XaverBandi/Qlockthree_Eva_und_Xaver/Photos/15.jpg

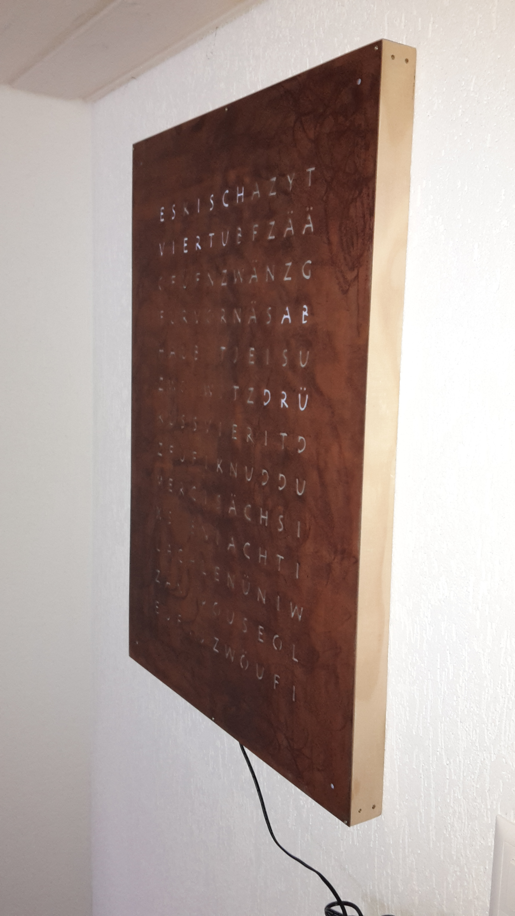
Photos/15.jpg
