XaverBandi/Qlockthree_Eva_und_Xaver/Photos/04.jpg

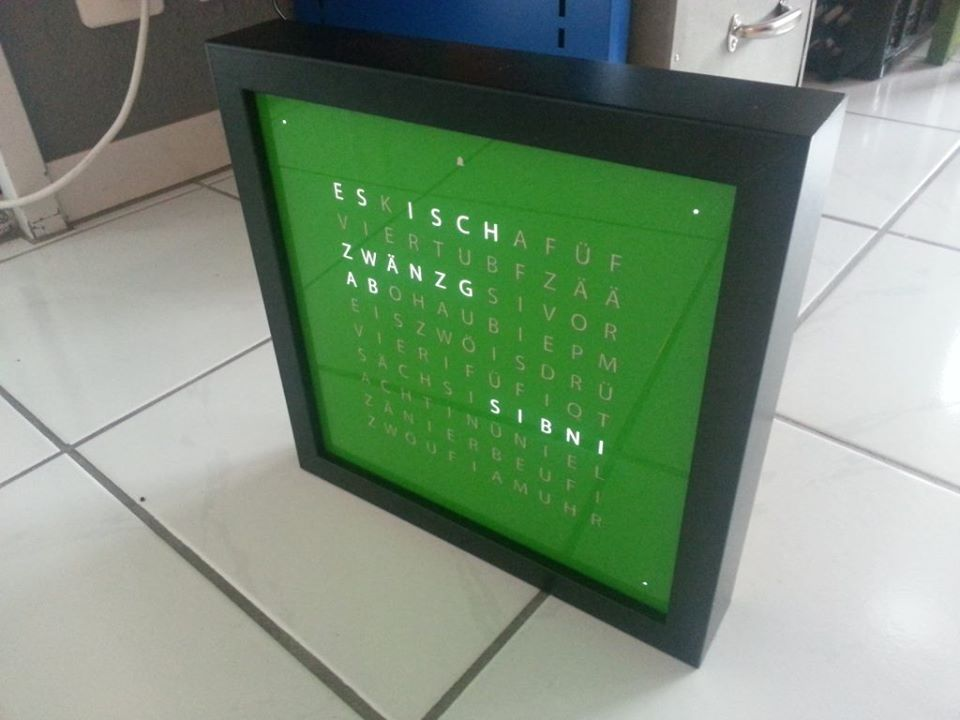
Photos/04.jpg
