XaverBandi/Qlockthree_Eva_und_Xaver/Anleitung/More/QLOCKTWO_Poster.pdf

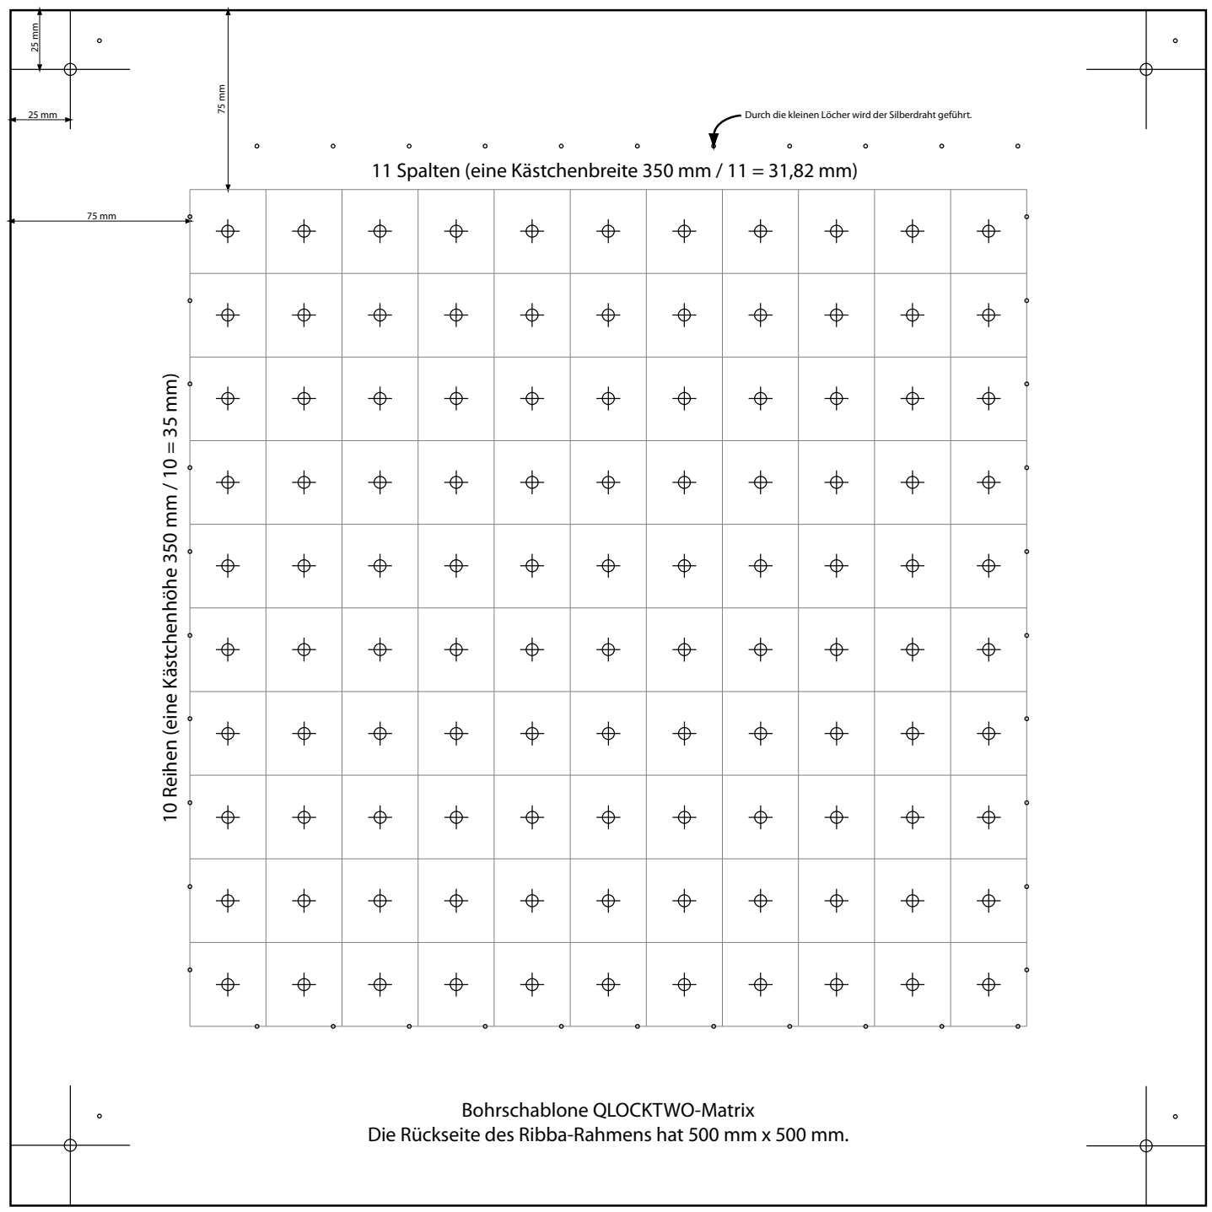
[picture p3: figure]
Bohrschablone QLOCKTWO-Matrix
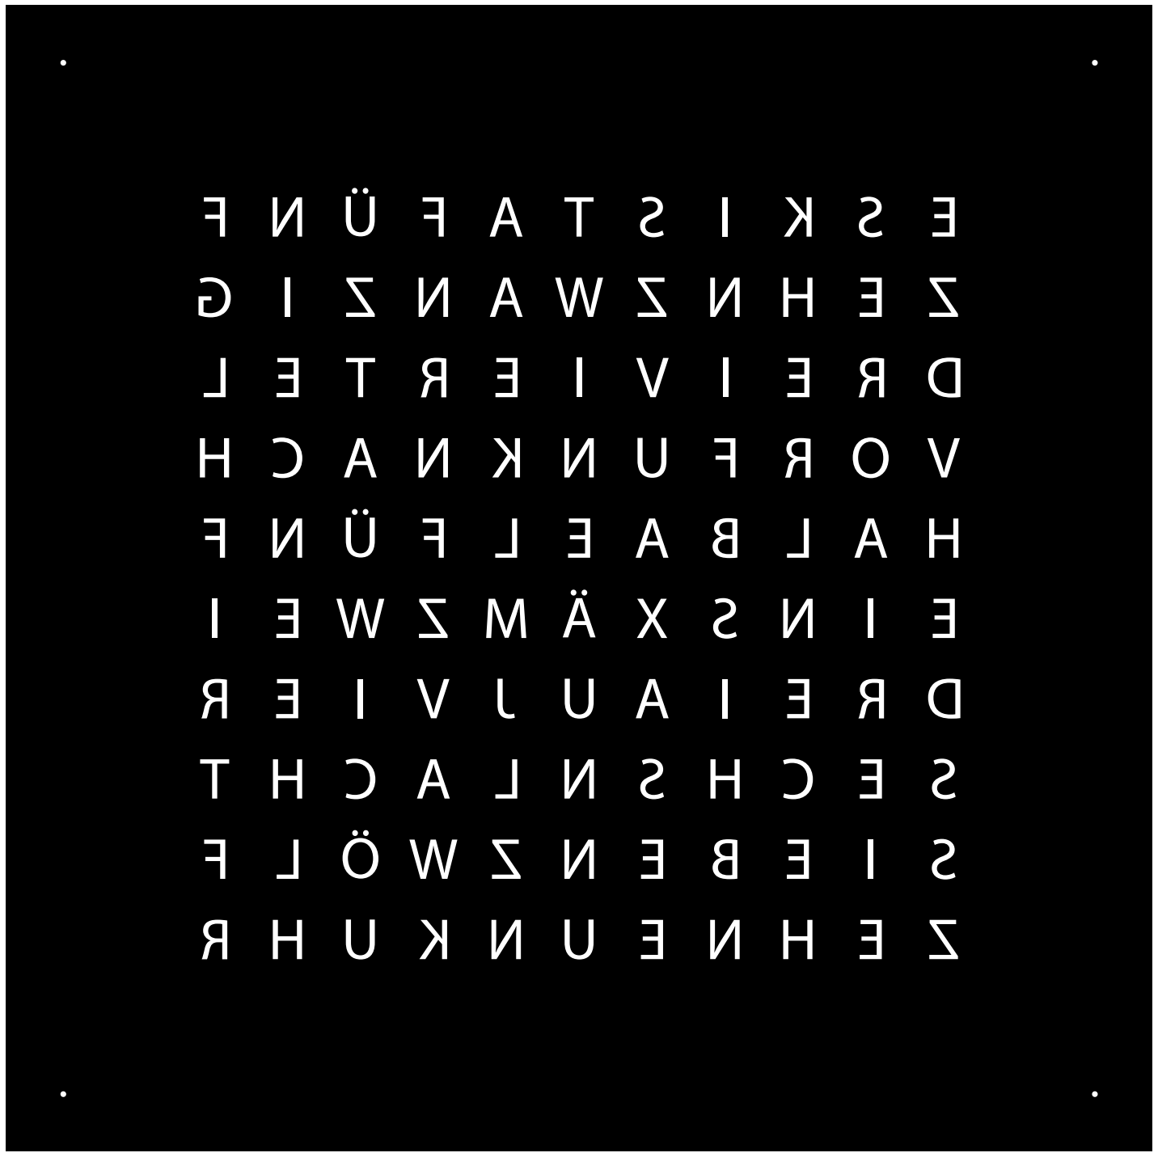
[picture p4: figure]

## 11 Spalten (eine Kästchenbreite 350 mm / 11 = 31,82 mm)

## 10 Reihen (eine Kästchenhöhe 350 mm / 10 = 35 mm)

Die Rückseite des Ribba-Rahmens hat 500 mm x 500 mm.

Durch die kleinen Löcher wird der Silberdraht geführt.

ache Seite,
kurzes Bein
= Kathode

runde Seite,
langes Bein
= Anode

## Lötschema QLOCKTWO-Matrix

Durch die kleinen Löcher wird der Silberdraht geführt.

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
STCLK

SHCLK
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
STCLK

SHCLK
MR

Q7‘

### Serial-In

### (vom Anoden-Multiplexer)

### Output-Enable

### Store-Clock (Latch)

### Serial-Clock

### Q0-Q7 und Q0-Q2 Matrix (GND)

### Q3-Q6 je eine Kathode

der Eck-LEDs. Oben links,
oben rechts, unten rechts, unten links.

Silberdraht Vcc
(Lötseite!)

Silberdraht GND
(Lötseite!)
1. Spalte
der LED-Matrix!

# Der Kathoden-Multiplexer:

# Der Anoden-Multiplexer:

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
STCLK

SHCLK
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
STCLK

SHCLK
MR

Q7‘

### Serial-In

### (vom RBBB)

### Output-Enable

### Store-Clock (Latch)

### Serial-Clock Serial-Out

### (zum Kathoden-Multiplexer)

Silberdraht Vcc
(Lötseite!)

Silberdraht GND
(Lötseite!)

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
OUT1

OUT2

OUT3

OUT4

OUT5

OUT6

OUT7

OUT8
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
OUT1

OUT2

OUT3

OUT4

OUT5

OUT6

OUT7

OUT8
GND

Out1-Out8 und Out1-Out2
zu den Anoden der Matrix | 1. Reihe
| der LED-
| Matrix!

# Die Steuerplatine:

### Signal vom DCF77-Empfänger

# Serial-Out (zum Anoden-Multiplexer) Taster „Modus“ Taster „Stunde+“

### Taster „Minute+“

### (alle zurück zu VCC)

### Output-Enable

### Store-Clock (Latch)

### Serial-Clock

Silberdraht Vcc
(Lötseite!)

Silberdraht GND
(Lötseite!)

3V für DCF77-Empfänger

X1

X2

VBAT

GND

VCC

SQW
SCL

SDA

### Achtung!

Quarz ist auf der Lötseite,

### damit das Gehäuse an GND liegen kann!

### Optionaler Schaltungsteil, für eine licht-

abhängige Steuerung.

D10

D11

D12

D13

GND

AREF
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
# ATMega 328 Rahmen

# Glasplatte

# Folie

# Diffusorfolie

# Abstandshalter

# Lichtleitgitter

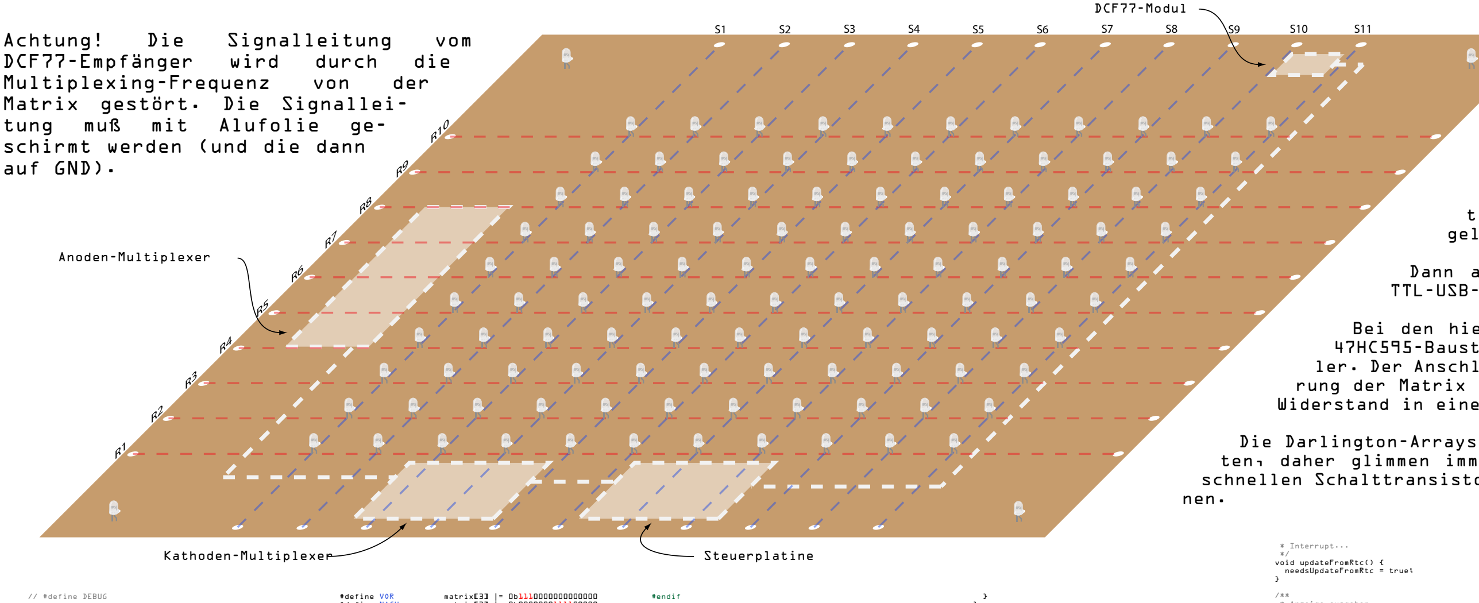
[picture p5: figure]
Anoden-Multiplexer; Kathoden-Multiplexer; Steuerplatine; DCF77-Modul; // #define DEBUG; #define VOR; matrix[3] |= 0b1110000000000000; #endif; * Interrupt... */ void updateFromRtc() { needsUpdateFromRtc = true;; nen.; Achtung!; Die; Signalleitung; vom; DCF77-Empfänger; wird; durch; die; Multiplexing-Frequenz; von; der; Matrix gestört. Die Signallei-; tung; muß; mit; Alufolie; schirmt werden (und die dann auf GND).

/**
* QLOCKTWO-Software
* V3, by Christian
* 2010/2011
*/

#include <Wire.h> // Wire library fuer I2C

#include "Dcf77.h"

#define DS1307_I2C_ADDRESS 0x68 // Die Real-Time-Clock

/**
* Definition der Zahlen.
*/
const byte zahl[10][7] = { {
0b00001110,
0b00010001,
0b00010011,
0b00010101,
0b00011001,
0b00010001,
0b00001110
}, {
0b00000010,
0b00000110,
0b00000010,
0b00000010,
0b00000010,
0b00000010,
0b00000111
}, {
0b00001110,
0b00010001,
0b00000001,
0b00000010,
0b00000100,
0b00001000,
0b00011111
}, {
0b00011111,
0b00000010,
0b00000100,
0b00000010,
0b00000001,
0b00010001,
0b00001110
}, {
0b00000010,
0b00000110,
0b00001010,
0b00010010,
0b00011111,
0b00000010,
0b00000010
}, {
0b00011111,
0b00010000,
0b00011110,
0b00000001,
0b00000001,
0b00010001,
0b00001110
}, {
0b00000110,
0b00001000,
0b00010000,
0b00011110,
0b00010001,
0b00010001,
0b00001110
}, {
0b00011111,
0b00000001,
0b00000010,
0b00000100,
0b00001000,
0b00001000,
0b00001000
}, {
0b00001110,
0b00010001,
0b00010001,
0b00001110,
0b00010001,
0b00010001,
0b00001110
}, {
0b00001110,
0b00010001,
0b00010001,
0b00001111,
0b00000001,
0b00000010,
0b00001100
}
};

/**
* Definition der Woerter.
*/
#define NACH | matrix[3] |= 0b0000000111100000

#define ESIST | matrix[0] |= 0b1101110000000000

#define UHR | matrix[9] |= 0b0000000011100000

#define FUENF | matrix[0] |= 0b0000000111100000

#define ZEHN | matrix[1] |= 0b1111000000000000

#define VIERTEL | matrix[2] |= 0b0000111111110000

#define ZWANZIG | matrix[1] |= 0b0000111111100000

#define HALB | matrix[4] |= 0b1111000000000000

#define DREIVIERTEL | matrix[2] |= 0b1111111111100000

#define H_EIN | matrix[5] |= 0b1110000000000000

#define H_EINS | matrix[5] |= 0b1111000000000000

#define H_ZWEI | matrix[5] |= 0b0000000111100000

#define H_DREI | matrix[6] |= 0b1111000000000000

#define H_VIER | matrix[6] |= 0b0000000111100000

#define H_FUENF | matrix[4] |= 0b0000000111100000

#define H_SECHS | matrix[7] |= 0b1111100000000000

#define H_SIEBEN | matrix[8] |= 0b1111110000000000

#define H_ACHT | matrix[7] |= 0b0000000111100000

#define H_NEUN | matrix[9] |= 0b0001111000000000

#define H_ZEHN | matrix[9] |= 0b1111000000000000

#define H_ELF | matrix[4] |= 0b0000011100000000

#define H_ZWOELF | matrix[8] |= 0b0000001111100000

/**
* Der serielle Ausgang zu den Multiplexern.
*/
#define latchPin | 11

#define clockPin | 12

#define dataPin | 10

#define outputEnablePin | 3

/**
* Die Funkuhr.
*/
#define dcf77Led | 8

#define dcf77Signal | 9

Dcf77 dcf77(dcf77Signal);
/**
* Das Rechtecksignal der RTC fuer den Interrupt. */
#define rtcSQWLed | 4

#define rtcSQWSignal | 2

/**
* Die Tasten.
*/
#define minutePlusPin 5

#define hourePlusPin | 6

#define modePin | 7

/**
* Die Modi.
*/
#define NORMAL | 0

#define SECONDS | 1

#define SCRAMBLE | 2

#define BLANK | 3

#define ALL | 4

#define MAX | 5

int mode = NORMAL;
/**
* Für das Entprellen der Tasten.
*/
unsigned long lastMinutePlusPress = 0; unsigned long lastHourePlusPress = 0; unsigned long lastModePress = 0;

// Ueber die Wire-Library festgelegt:
// Arduino analog input 4 = I2C SDA
// Arduino analog input 5 = I2C SCL

// Die Matrix, eine Art Bildschirmspeicher... word matrix[16];

// Die letzten Zeitstempel und Minutenabstände #define MAX_STEMPEL 4
long zeitstempelDcf77[MAX_STEMPEL];
long zeitstempelRtc[MAX_STEMPEL];

// Die Zeit...
byte second = 1;
byte minute = 1;
byte hour = 1;
byte dayOfWeek = 1;
byte dayOfMonth = 1;
byte month = 1;
byte year = 1;

// Hilfsvariable, da I2C und Interrupts // nicht zusammenspielen...
volatile boolean needsUpdateFromRtc = true;

/**
* Doku...
* 1. Fehler -> Falsche LED
* 2. Fehler -> Seltsames Verhalten mit Mac+USB+3.3v * 3. Fehler -> attachInterrupt & die Wire-Library
* | gehen nicht zusammen!
*/
void setup() {
#ifdef DEBUG

Serial.begin(57600);
Serial.println("Starting in debug-mode...");

Wire.begin(); // starte Wire library als I2C-Bus Master

pinMode(latchPin, OUTPUT);
pinMode(clockPin, OUTPUT);
pinMode(dataPin, OUTPUT);
pinMode(outputEnablePin, OUTPUT); digitalWrite(outputEnablePin, LOW);

pinMode(minutePlusPin, INPUT); pinMode(hourePlusPin, INPUT); pinMode(modePin, INPUT);
lastMinutePlusPress = millis(); lastHourePlusPress = millis(); lastModePress = millis();

pinMode(dcf77Signal, INPUT); digitalWrite(dcf77Signal, HIGH); pinMode(dcf77Led, OUTPUT); digitalWrite(dcf77Led, HIGH);

pinMode(rtcSQWSignal, INPUT); digitalWrite(rtcSQWSignal, HIGH); pinMode(rtcSQWLed, OUTPUT); digitalWrite(rtcSQWLed, HIGH);

clear();

getDateDs1307();

attachInterrupt(0, updateFromRtc, CHANGE);

for(int i=0; i<MAX_STEMPEL; i++) { zeitstempelDcf77[i] = i;
zeitstempelRtc[i] = i+1;
}
}

void loop() {
// via Interrupt gesetzt ueber Flanke des // SQW-Signals von der RTC
if (needsUpdateFromRtc) {
clear();
getDateDs1307();

switch (mode) {
case NORMAL:
setWords(hour, minute);
setMinutes(minute);
break;
case SECONDS:
for (int i = 0; i < 7; i++) {
matrix[1 + i] |= zahl[second / 10][i] << 11; }
for (int i = 0; i < 7; i++) {
matrix[1 + i] |= zahl[second % 10][i] << 5; }
break;
case SCRAMBLE:
scramble();
break;
case BLANK:
clear();
break;
case ALL:
all();
break;
}

needsUpdateFromRtc = false; }

// Taste Minuten++?
if (digitalRead(minutePlusPin) == HIGH) {
if (lastMinutePlusPress + 200 < millis()) { #ifdef DEBUG
Serial.println("\nMinutes plus pressed..."); #endif
minute++;
if (minute > 59) {
minute = 1;
}
setDateDs1307();
lastMinutePlusPress = millis(); needsUpdateFromRtc = true;
}
}

// Taste Stunden++?
if (digitalRead(hourePlusPin) == HIGH) {
if (lastHourePlusPress + 200 < millis()) { #ifdef DEBUG
Serial.println("\nHours plus pressed..."); #endif
hour++;
if (hour > 12) {
hour = 1;
}
setDateDs1307();
lastHourePlusPress = millis(); needsUpdateFromRtc = true;

}

// Taste Moduswechsel?
if (digitalRead(modePin) == HIGH) { if (lastModePress + 200 < millis()) {
mode++;
#ifdef DEBUG

Serial.print("\nChange mode pressed, mode is now "); Serial.print(mode);
Serial.println("...");
#endif

if(mode == MAX) {
mode = 0;
}
lastModePress = millis();
needsUpdateFromRtc = true;
}
}

// Die Matrix auf die LEDs multiplexen... if(mode != BLANK) {
writeMatrix();
}

// Status-LEDs ausgeben...
digitalWrite(dcf77Led, digitalRead(dcf77Signal)); digitalWrite(rtcSQWLed, digitalRead(rtcSQWSignal));

const char *v = dcf77.getDateTime();
if (strcmp (v, "DCF77POLL") != 0) {
#ifdef DEBUG

Serial.print("Captured:_"); Serial.println(v);
#endif

if(dcf77.getYear() > 2010) {
long dcf77inMinutes = dcf77.getHoures()*60 + dcf77.getMinutes();
long rtcInMinutes = hour*60 + minute; #ifdef DEBUG
Serial.print("\ndcf77inMinutes: "); Serial.println(dcf77inMinutes); Serial.print("rtcInMinutes: "); Serial.println(rtcInMinutes);
#endif

for(int i=0; i<MAX_STEMPEL-1; i++) { zeitstempelDcf77[i] = zeitstempelDcf77[i+1]; zeitstempelRtc[i] = zeitstempelRtc[i+1];
}
zeitstempelDcf77[MAX_STEMPEL-1] = dcf77inMinutes; zeitstempelRtc[MAX_STEMPEL-1] = rtcInMinutes;

// stimmen die Abstände im Array?
boolean ok = true;
for(int i=0; i<MAX_STEMPEL-1; i++) { if((zeitstempelDcf77[i] - zeitstempelDcf77[i+1]) != (zeitstempelRtc[i] - zeitstempelRtc[i+1])) { ok = false;
#ifdef DEBUG

Serial.print("Diff #");
Serial.print(i);
Serial.print(" is false ("); Serial.print(zeitstempelDcf77[i] -zeitstempelDcf77[i+1]);
Serial.print("!=");
Serial.print(zeitstempelRtc[i] -zeitstempelRtc[i+1]);
Serial.println(").");
#endif

} else {
#ifdef DEBUG

Serial.print("Diff #");
Serial.print(i);
Serial.print(" ok (");
Serial.print(zeitstempelDcf77[i] -zeitstempelDcf77[i+1]);
Serial.print("==");
Serial.print(zeitstempelRtc[i] -zeitstempelRtc[i+1]);
Serial.println(").");
#endif

}
}

if(ok) {
second = 0;
minute = dcf77.getMinutes(); hour = dcf77.getHoures();
setDateDs1307();
}
} else {
#ifdef DEBUG

Serial.println("DCF77-Time trashed because wrong distances between timestamps.");
#endif

}
}
}

/**
* Aenderung der Anzeige als Funktion fuer einen

* Anzeige ausgeben...
*/
void writeMatrix() {
word row = 1;
for (word k = 0; k < 16; k++) { prepareShiftregisterWrite();

shiftIt(~matrix[k]);
shiftIt(row);

finishShiftregisterWrite(); row = row << 1;
}
}

/**
* Setzt die vier Punkte in den Ecken, je nach * minutes % 5 (Rest)
*/
void setMinutes(int minutes) {
switch (minutes % 5) {
case 0:
break;
case 1:
matrix[1] |= 0b0000000000010000; // 1 break;
case 2:
matrix[1] |= 0b0000000000010000; // 1 matrix[0] |= 0b0000000000001000; // 2 break;
case 3:
matrix[1] |= 0b0000000000010000; // 1 matrix[0] |= 0b0000000000001000; // 2 matrix[3] |= 0b0000000000000100; // 3 break;
case 4:
matrix[1] |= 0b0000000000010000; // 1 matrix[0] |= 0b0000000000001000; // 2 matrix[3] |= 0b0000000000000100; // 3 matrix[2] |= 0b0000000000000010; // 4 break;
}
}

/**
* Setzt die Wortminuten, je nach houres/minutes. * Achtung! Die 'kleinen' Bits fallen rechts raus! */
void setWords(int houres, int minutes) {
while (houres > 12) {
houres -= 12;
}

ESIST;

switch (minutes / 5) {
case 0:
// glatte Stunde
setHoures(houres, true);
break;
case 1:
// 5 nach
FUENF;
NACH;
setHoures(houres, false);
break;
case 2:
// 10 nach
ZEHN;
NACH;
setHoures(houres, false);
break;
case 3:
// viertel
VIERTEL;
setHoures(houres + 1, false); break;
case 4:
// 20 nach
ZWANZIG;
NACH;
setHoures(houres, false);
break;
case 5:
// 5 vor halb
FUENF;
VOR;
HALB;
setHoures(houres + 1, false); break;
case 6:
// halb
HALB;
setHoures(houres + 1, false); break;
case 7:
// 5 nach halb
FUENF;
NACH;
HALB;
setHoures(houres + 1, false); break;

case 8:
// 20 vor
ZWANZIG;
VOR;
setHoures(houres + 1, false); break;
case 9:
// dreiviertel
DREIVIERTEL;
setHoures(houres + 1, false); break;
case 10:
// 10 vor
ZEHN;
VOR;
setHoures(houres + 1, false); break;
case 11:
// 5 vor
FUENF;
VOR;
setHoures(houres + 1, false); break;
}
}

/**
* Setzt die Stunden, je nach houres.
* Achtung! Die 'kleinen' Bits fallen rechts raus! */
void setHoures(int houres, boolean glatt) {
while (houres > 12) {
houres -= 12;
}

if (glatt) {
UHR;
}

switch (houres) {
case 0:
case 12:
case 24:
H_ZWOELF;
break;
case 1:
case 13:
if (glatt) {
H_EIN;
}
else {
H_EINS;
}
break;
case 2:
case 14:
H_ZWEI;
break;
case 3:
case 15:
H_DREI;
break;
case 4:
case 16:
H_VIER;
break;
case 5:
case 17:
H_FUENF;
break;
case 6:
case 18:
H_SECHS;
break;
case 7:
case 19:
H_SIEBEN;
break;
case 8:
case 20:
H_ACHT;
break;
case 9:
case 21:
H_NEUN;
break;
case 10:
case 22:
H_ZEHN;
break;
case 11:
case 23:
H_ELF;
break;
}
}

/**
* Ein Zufallsmuster erzeugen (zum Testen)... */
void scramble() {
for (int i = 0; i < 16; i++) {
matrix[i] = random(65536); }
}

/**
* Die Matrix loeschen...
*/

void clear() {
for (int i = 0; i < 16; i++) { matrix[i] = 0;
}
}

/**
* Die Matrix setzen...
*/
void all() {
for (int i = 0; i < 16; i++) { matrix[i] = 65535;
}
}

/**
* Daten seriell ausgeben...
*/
void shiftIt(word dataOut) { for (word b = 0; b < 16; b++) { digitalWrite(clockPin, LOW); if (dataOut & (1 << b)) {
digitalWrite(dataPin, HIGH); }
else {
digitalWrite(dataPin, LOW); }
digitalWrite(clockPin, HIGH); }
}

/**
* Vorbereiten des seriellen Schreibens... */
void prepareShiftregisterWrite() { digitalWrite(dataPin, LOW); digitalWrite(clockPin, LOW); digitalWrite(latchPin, LOW);
}

/**
* Abschliessen des seriellen Schreibens... */
void finishShiftregisterWrite() { digitalWrite(dataPin, LOW); digitalWrite(clockPin, LOW); digitalWrite(latchPin, HIGH);
}

/**
* Convert normal decimal numbers to binary coded decimal */
byte decToBcd(byte val) {
| return ( (val / 10 * 16) + (val % 10));
}

/**
* Convert binary coded decimal to normal decimal numbers */
byte bcdToDec(byte val) {
| return ( (val / 16 * 10) + (val % 16));
}

/**
* Die Zeit aus der Real-Time-Clock lesen... */
void getDateDs1307() {
| // Reset the register pointer
| Wire.beginTransmission(DS1307_I2C_ADDRESS);
| Wire.send(0x00);
| Wire.endTransmission();
| Wire.requestFrom(DS1307_I2C_ADDRESS, 7);
| // A few of these need masks because certain bits are
control bits
| second = bcdToDec(Wire.receive() & 0x7f);
| minute = bcdToDec(Wire.receive());
| hour = bcdToDec(Wire.receive() & 0x3f); // Need to change
this if 12 hour am/pm
| dayOfWeek = bcdToDec(Wire.receive());
| dayOfMonth = bcdToDec(Wire.receive());
| month = bcdToDec(Wire.receive());
| year = bcdToDec(Wire.receive());
}

/**
* Die Zeit in der Real-Time-Clock setzen... */
void setDateDs1307() {
| Wire.beginTransmission(DS1307_I2C_ADDRESS);
| Wire.send(0x00);
| Wire.send(decToBcd(second)); // 0 to bit 7 starts the
clock
| Wire.send(decToBcd(minute));
| Wire.send(decToBcd(hour)); // If you want 12 hour am/pm
you need to set
| // bit 6 (also need to change readDateDs1307)
| Wire.send(decToBcd(dayOfWeek));
| Wire.send(decToBcd(dayOfMonth));
| Wire.send(decToBcd(month));
| Wire.send(decToBcd(year));
| Wire.send(0b00010000); // 1Hz Rechteck auf SQW für den
Display-Update-Interrupt...
Wire.endTransmission();
}

# Als erstes kauft man sich einen Ribba-Rahmen bei IKEA und lässt bei einem Digitaldrucker eine Folie nach der Vorlage mit den spiegelverkehrten Buchstaben schneiden. Diese wird dann auf die Rückseite des

Ribba-Rahmen-Glas aufkaschiert.

# Dann bohrt man in die Rückseite des Ribba-Rahmens nach der Bohrschablone die Löcher für die LEDs mit 5mm und ganz kleine Löcher für die Durchführung der Silberdrähte (Tipp: die Bohr-

schablone unskaliert ausdrucken, zusammenkleben und auflegen).

# Die Löcher für die Anoden links nicht am Rahmenrand bohren, sondern am Lichtgitterrand - dann müssen später die Drähte vom Multi-

plexer zur Matrix nicht gekreuzt werden.

# Der nächste Schritt besteht darin, auf der Rückseite der Ribba-Rahmen-Rückwand die Silberdrähte zu ziehen und die LEDs zu stecken. Dann werden die LEDs wie im Lötschema gelötet. Damit die Spalten und Reihen keinen Kurz-

schluß bilden, werden sie mit Fotokartonstreifen getrennt.

# Der RBBB wird nach der Anleitung (bei Jee-Labs downloaden) zusammengelötet. Nur bei der Stromversorgung muß man aufpassen. Je nach Netzteil, das man noch so rumliegen hat, oder Bedürfnissen (Strom von außen ansteckbar) lötet man den Power-Jack

auf das RBBB oder eben auch nicht.

Dann kommt der Kathoden-Mutliplexer, er ist die einfachste Platine. Als Kabel eigenen sich hervorragend Steckbrücken für das Steckbrett, für die kurzen Brücken sind abgezwickte LED-Beine prima geeignet. Das Schema oben zeigt die Dreierreihen aus Kupfer, aber nur zur besseren Orientierung, sie sind natürlich auf der Rückseite und nicht sichtbar.

Der Anoden-Mutliplexer ist genauso wie der Kathoden-Multiplexer, nur enthält er die Darlington-Arrays zur Verstärkung.

Bei der Steuerplatine ist zu beachten, daß der Quarz auf einer „Ground-Platte“ liegen sollte, also am Besten auf der Rückseite anlöten. Die grüne und gelbe LED kann natürlich auch auf den Rahmen herausgeführt werden, oder mit einer POF (Polymer-Optical-Fiber) nach außen geführt werden. Eine günstige POF ist ein TOS-Link-Kabel aus dem Elektro-Markt, dem man die Stecker ab-

schneidet.

# Bei dem DCF77-Empfänger ist darauf zu achten, daß er möglichst weit weg von den Mutliplexern ist und die Leitungen zur Steuerplatine am besten mit Alufolie abgeschirmt werden, die dann auf GND

gelegt wird.

# Dann alles zusammenlöten, die Software via USB-BUB oder einem anderen TTL-USB-Kabel aufspielen und fertig ist die QLOCKTWO!

Bei den hier gezeigten Multiplexern ist der OE-Anschluß (Output Enable) der 47HC595-Bausteine (Shift-Register) schon ein eigener Pin am ATMega-Microcontroller. Der Anschluß D3 kann PWM (Pulse-Width-Modulation), was eine Helligkeitssteuerung der Matrix ermöglicht. Die Helligkeit könnte z. B. über einen lichtabhängigen

Widerstand in einem Spannungsteiler an einem der analogen Pins gemessen werden.

# Die Darlington-Arrays können leider nicht mit der Frequenz der Matrix-Steuerung mithalten, daher glimmen immer ein paar LEDs um das aktuelle Wort herum. Das könnte man mit

schnellen Schalttransistoren umgehen, hat dann aber auch viele Bauteile mehr auf den Plati-

# Online-Ressourcen:

# Bauanleitung: www.caschoff.de Reichelt: www.reichelt.de Arduino: www.arduino.cc Jee-Labs: jeelabs.org Pollin: www.pollin.de
