XaverBandi/Qlockthree_Eva_und_Xaver/Photos/01.jpg

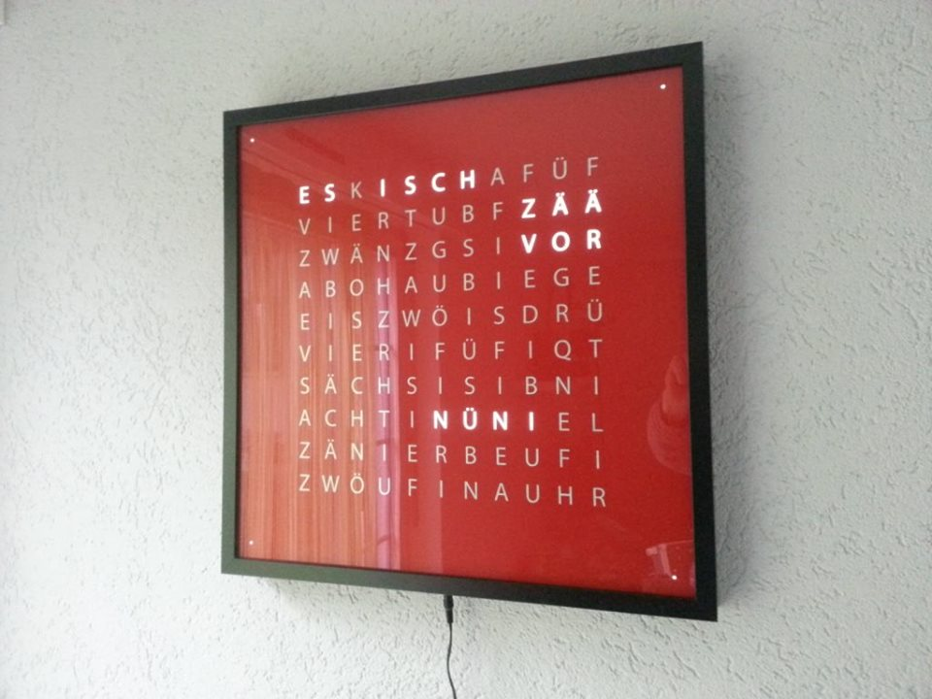
Photos/01.jpg
