XaverBandi/Qlockthree_Eva_und_Xaver/Photos/02.jpg

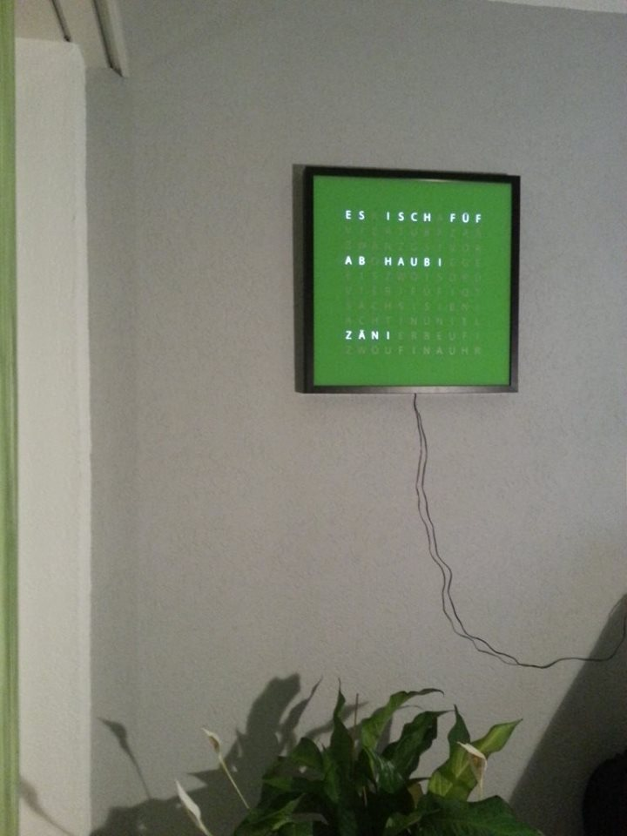
Photos/02.jpg
