XaverBandi/Qlockthree_Eva_und_Xaver/Photos/03.jpg

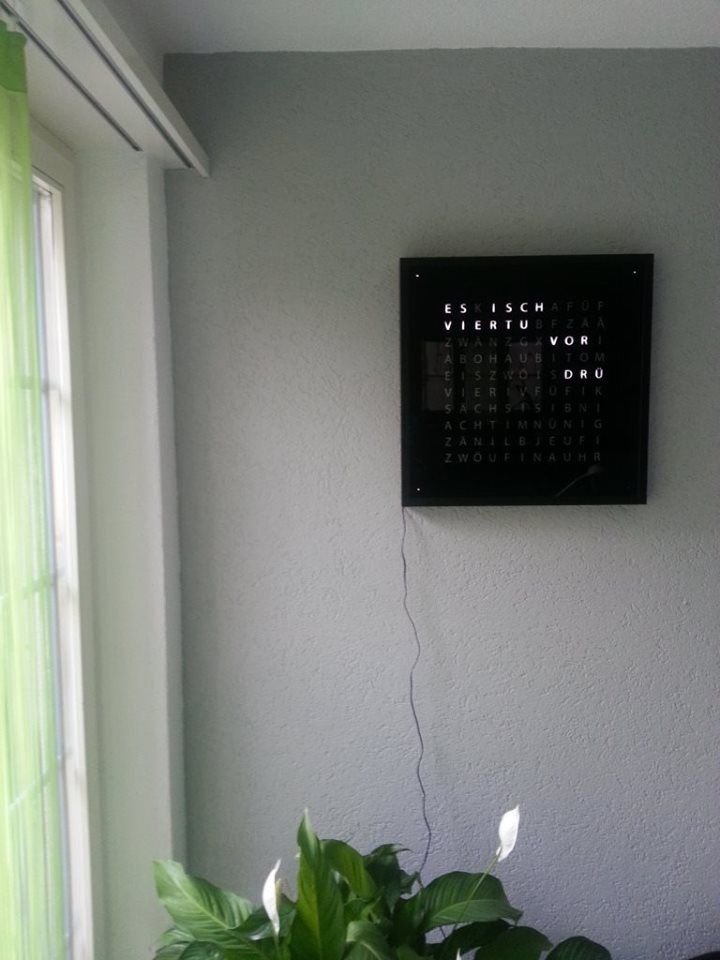
Photos/03.jpg
