XaverBandi/Qlockthree_Eva_und_Xaver/Photos/05.jpg

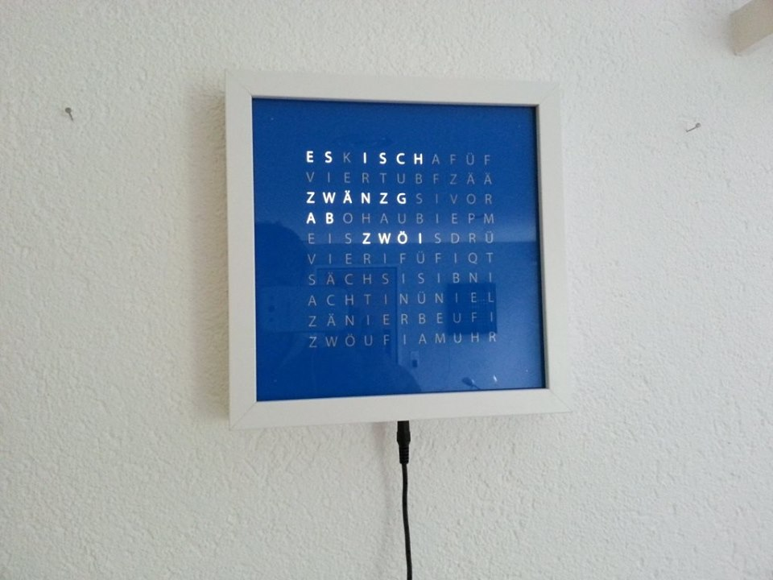
Photos/05.jpg
