XaverBandi/Qlockthree_Eva_und_Xaver/Photos/06.jpg

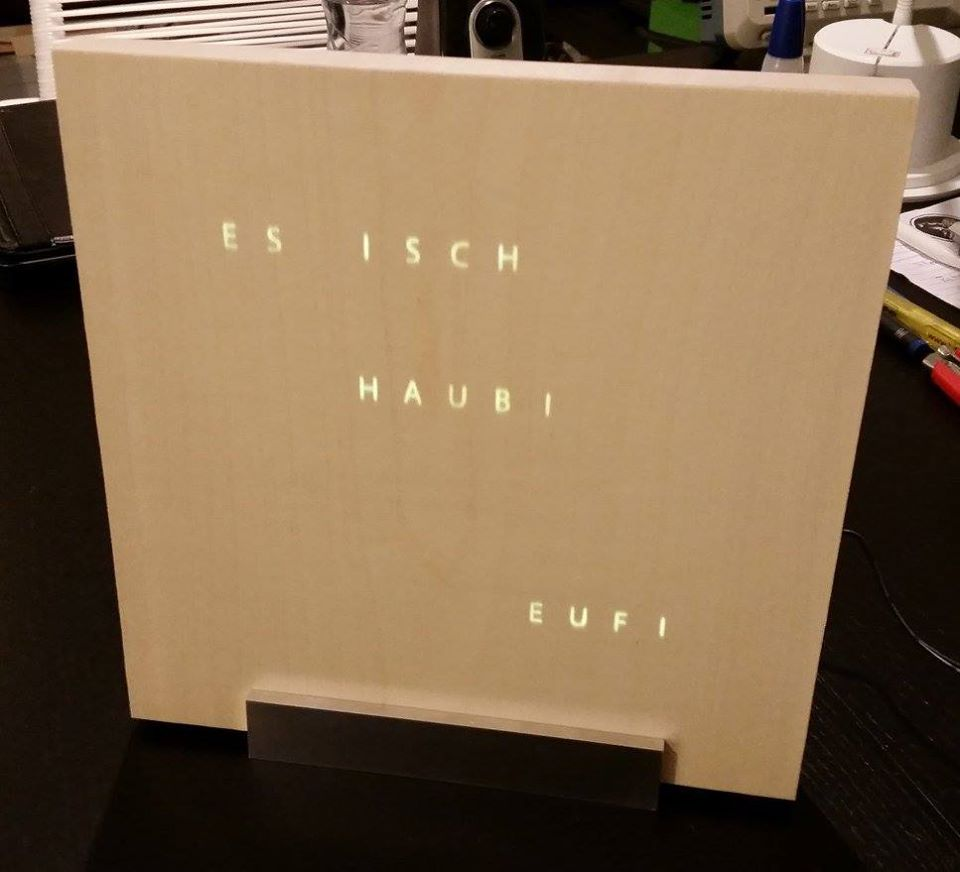
Photos/06.jpg
