XaverBandi/Qlockthree_Eva_und_Xaver/Photos/07.jpg

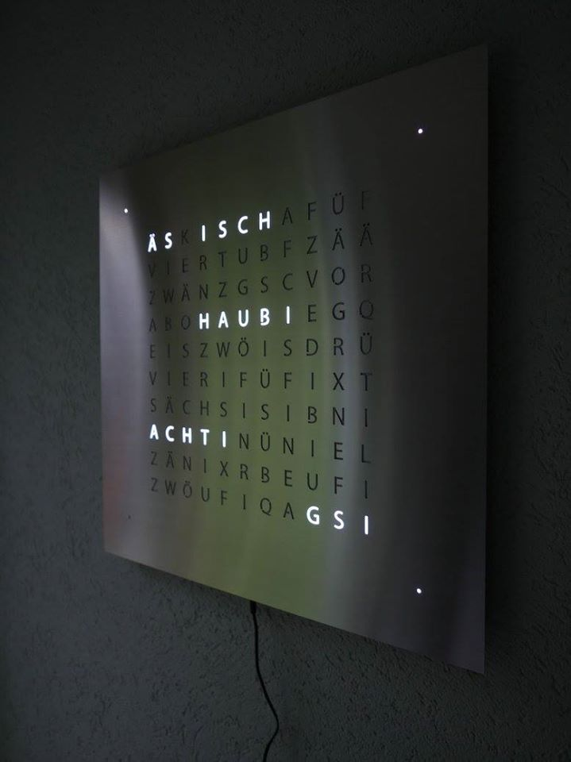
Photos/07.jpg
