XaverBandi/Qlockthree_Eva_und_Xaver/Photos/08.jpg

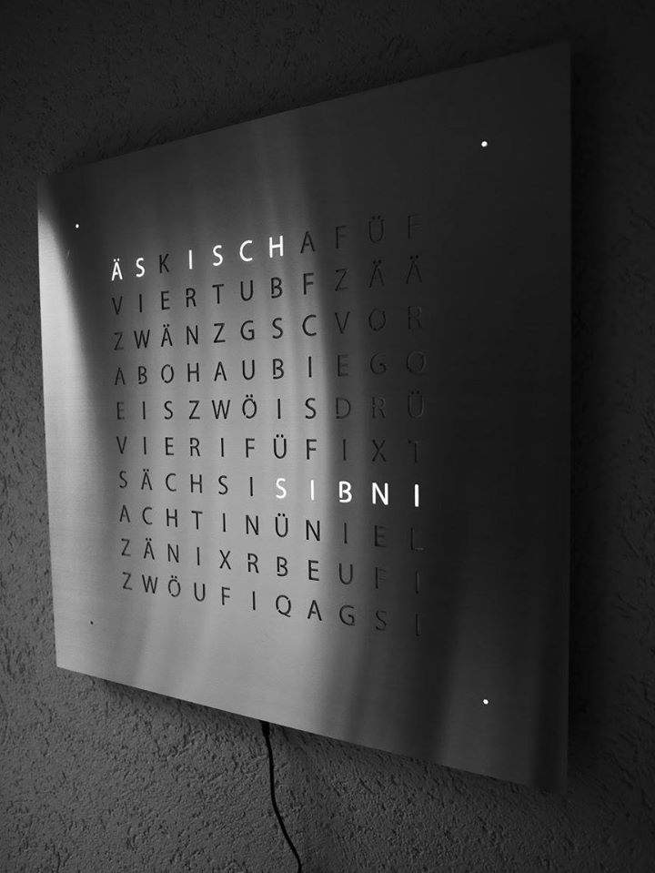
Photos/08.jpg
