XaverBandi/Qlockthree_Eva_und_Xaver/Photos/09.jpg

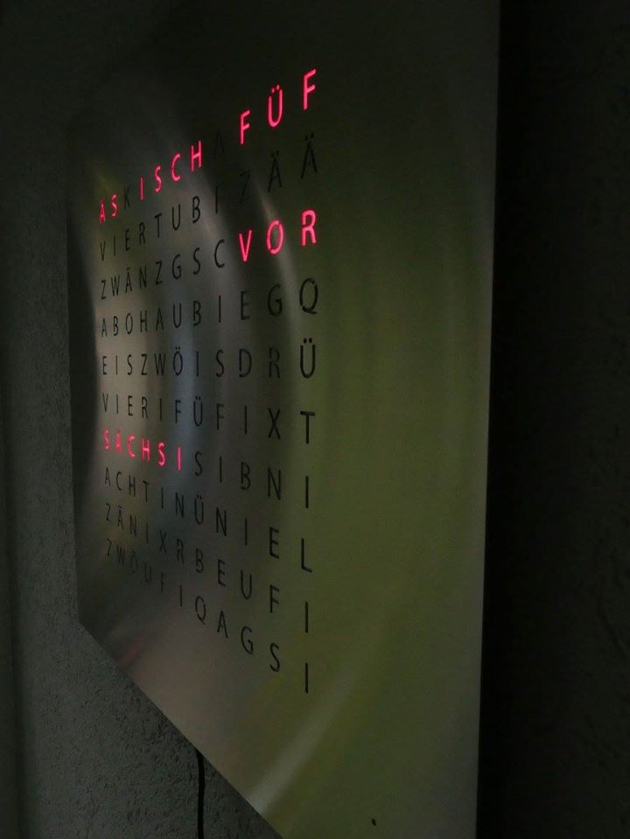
Photos/09.jpg
