XaverBandi/Qlockthree_Eva_und_Xaver/Photos/10.jpg

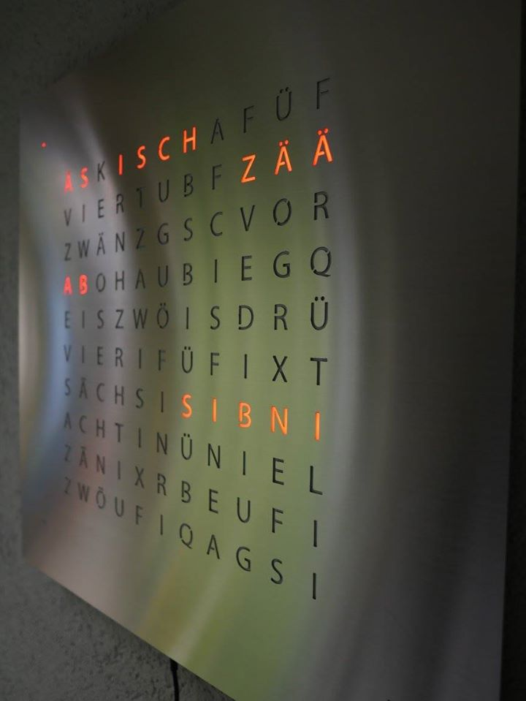
Photos/10.jpg
