XaverBandi/Qlockthree_Eva_und_Xaver/Photos/11.jpg

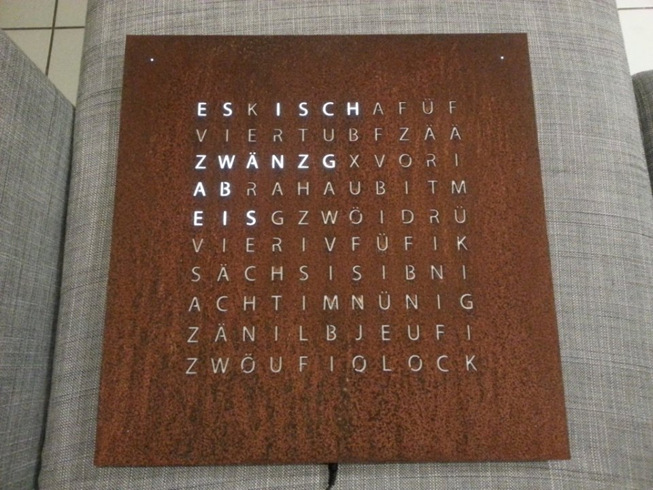
Photos/11.jpg
