XaverBandi/Qlockthree_Eva_und_Xaver/Photos/12.jpg

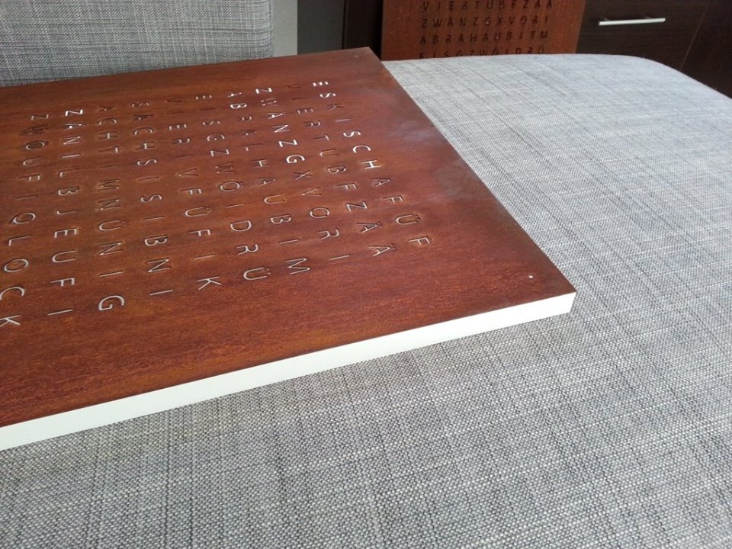
Photos/12.jpg
