XaverBandi/Qlockthree_Eva_und_Xaver/Photos/13.jpg

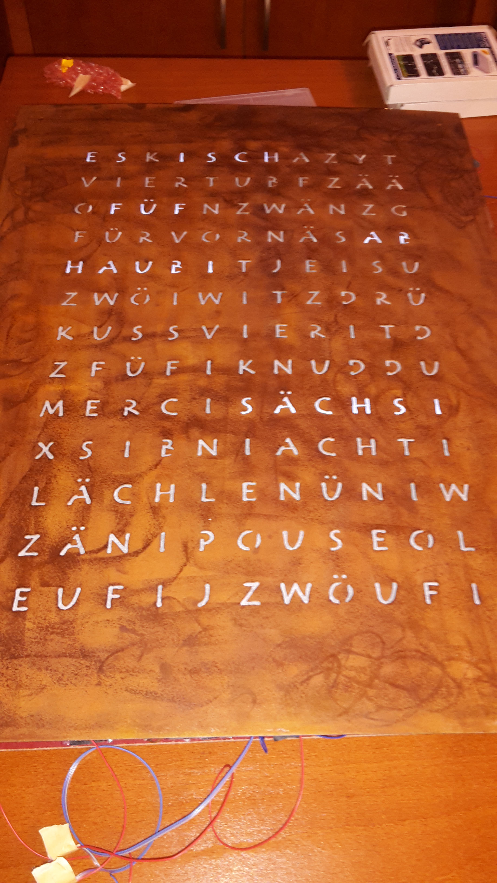
Photos/13.jpg
