XaverBandi/Qlockthree_Eva_und_Xaver/Photos/14.jpg

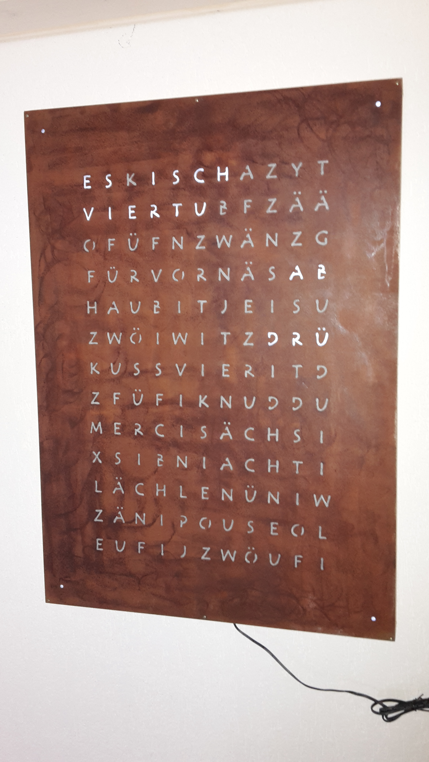
Photos/14.jpg
