XaverBandi/Qlockthree_Eva_und_Xaver/Schablone/Folie1.GIF

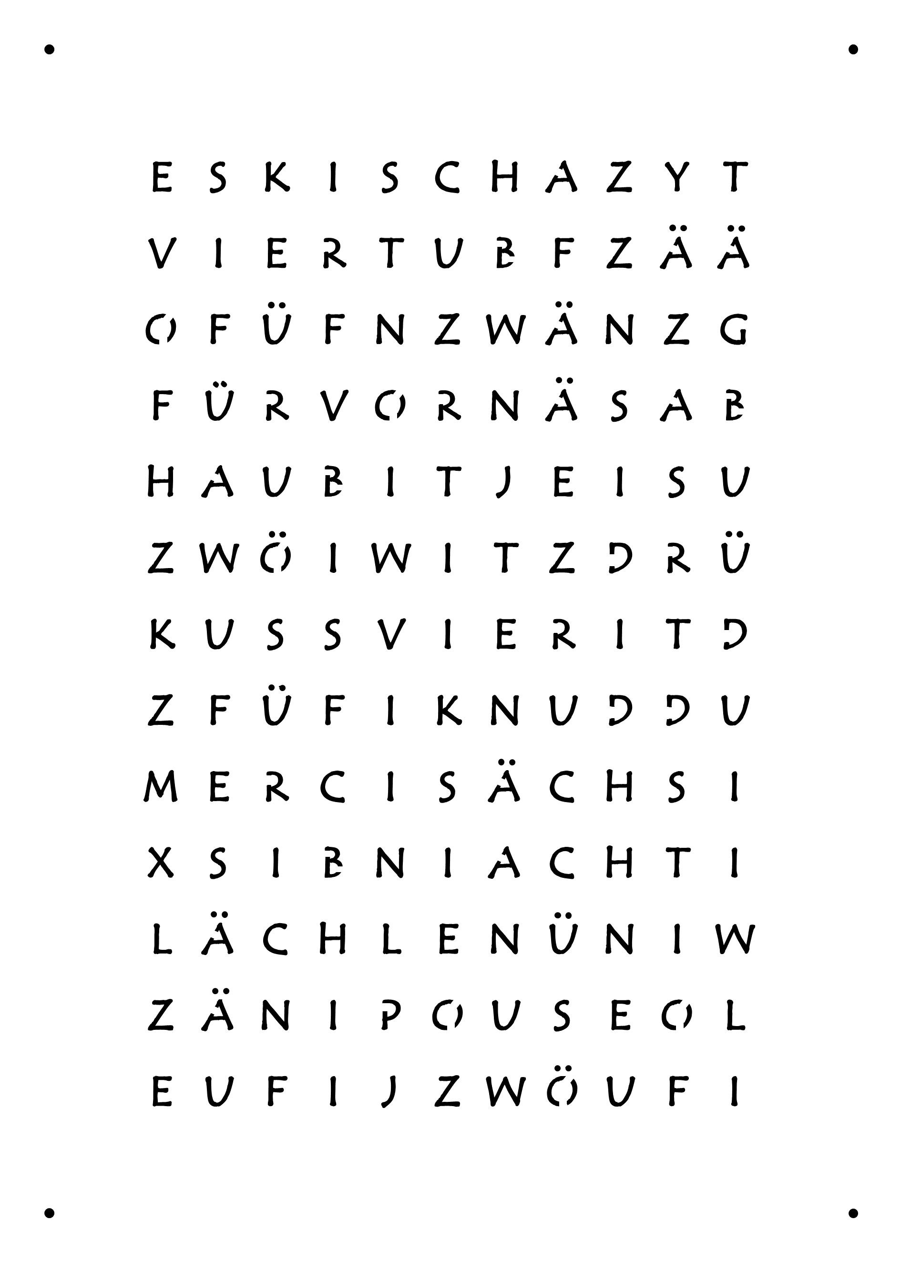
Schablone/Folie1.GIF
