XaverBandi/Qlockthree_Eva_und_Xaver/Schablone/Schablone-Wortuhr.dxf

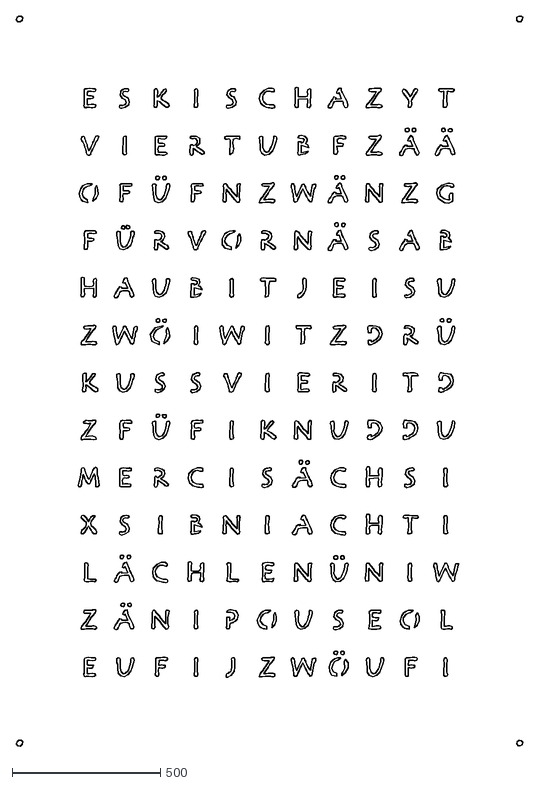
[picture p20: CAD file, 2016-06-18]
Schablone/Schablone-Wortuhr.dxf
1707.0 x 2462.0
