XaverBandi/Qlockthree_Eva_und_Xaver/Anleitung/More/Anoden-Multiplexer_v1.1.pdf

# Der Anoden-Multiplexer:

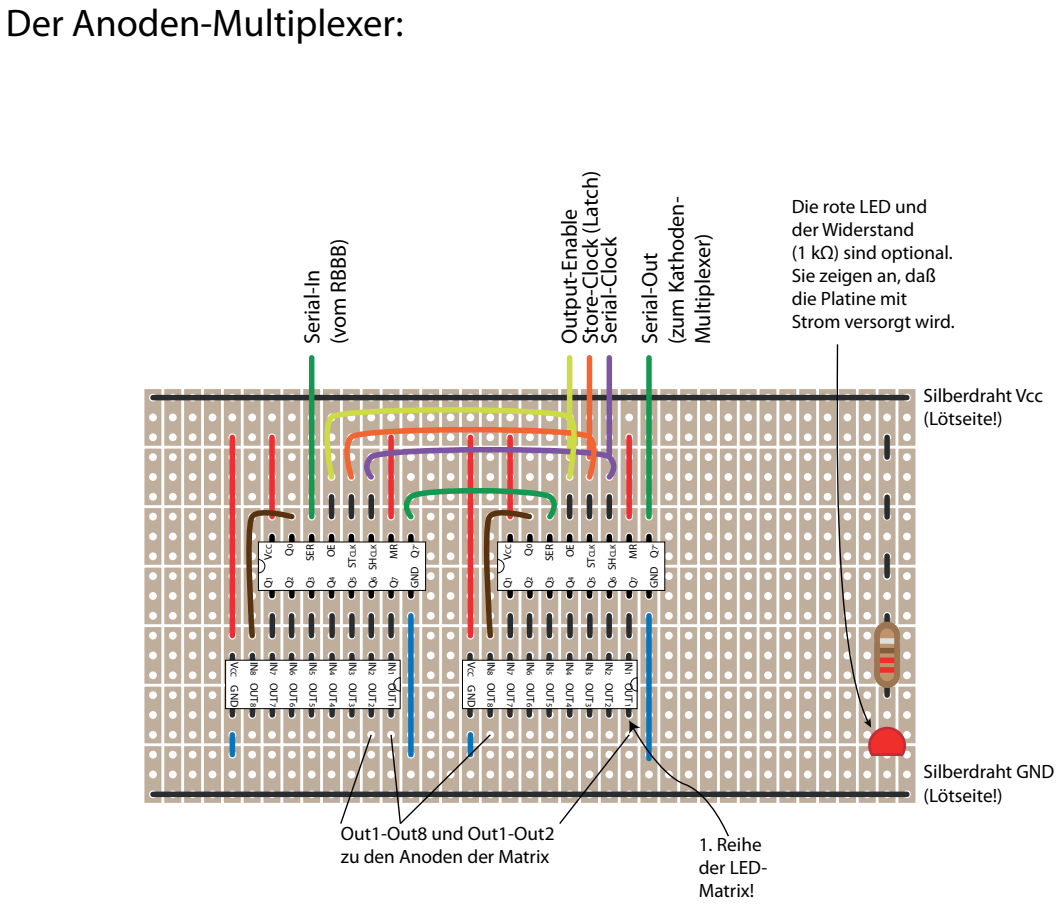
[picture p29: page 1]

Die rote LED und
der Widerstand
(1 kΩ) sind optional.
Sie zeigen an, daß
die Platine mit
Strom versorgt wird.
