XaverBandi/Qlockthree_Eva_und_Xaver/Anleitung/More/Kathoden-Multiplexer_v1.2.pdf

# Der Kathoden-Multiplexer:

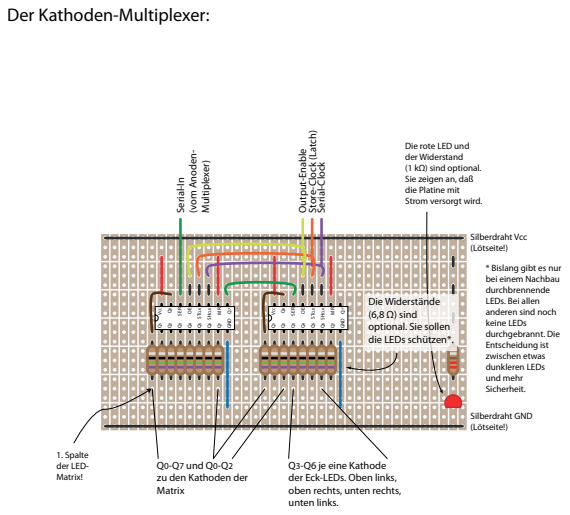
[picture p30: page 1]
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

Silberdraht Vcc
(Lötseite!)
* Bislang gibt es nur
bei einem Nachbau
durchbrennende
LEDs. Bei allen
anderen sind noch
keine LEDs

Q0-Q7 und Q0-Q2
zu den Kathoden der
Matrix

Q3-Q6 je eine Kathode
der Eck-LEDs. Oben links,
oben rechts, unten rechts,
unten links.
