XaverBandi/Qlockthree_Eva_und_Xaver/Anleitung/More/Steuerplatine_v1.5.pdf

Die Steuerplatine: Signal vom DCF77-Empfänger Serial-Out (zum Anoden-Multiplexer) Taster „Modus“ Taster „Stunde+“

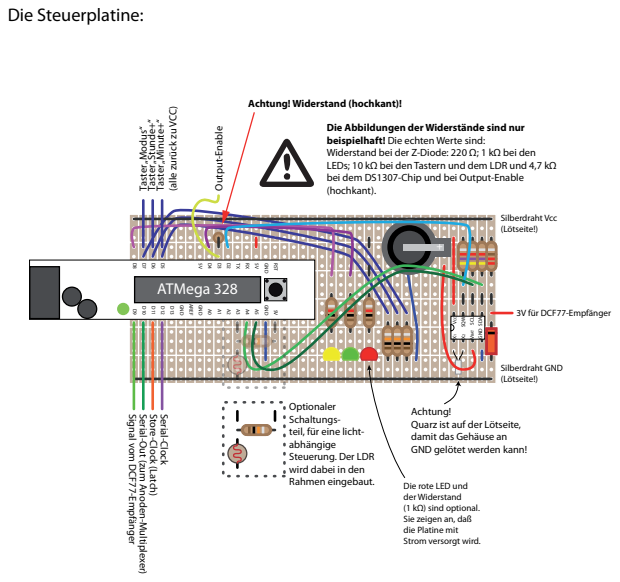
[picture p31: page 1]

(alle zurück zu VCC)

Die Abbildungen der Widerstände sind nur
beispielhaft! Die echten Werte sind:
Widerstand bei der Z-Diode: 220 Ω; 1 kΩ bei den
LEDs; 10 kΩ bei den Tastern und dem LDR und 4,7 kΩ
bei dem DS1307-Chip und bei Output-Enable
(hochkant).

Optionaler
Schaltungs-
teil, für eine licht-
abhängige
Steuerung. Der LDR
wird dabei in den

Achtung!
Quarz ist auf der Lötseite,
damit das Gehäuse an
GND gelötet werden kann!

der Widerstand
(1 kΩ) sind optional.
Sie zeigen an, daß
die Platine mit
Strom versorgt wird.
