XaverBandi/Qlockthree_Eva_und_Xaver/Anleitung/More/Schablone.pdf

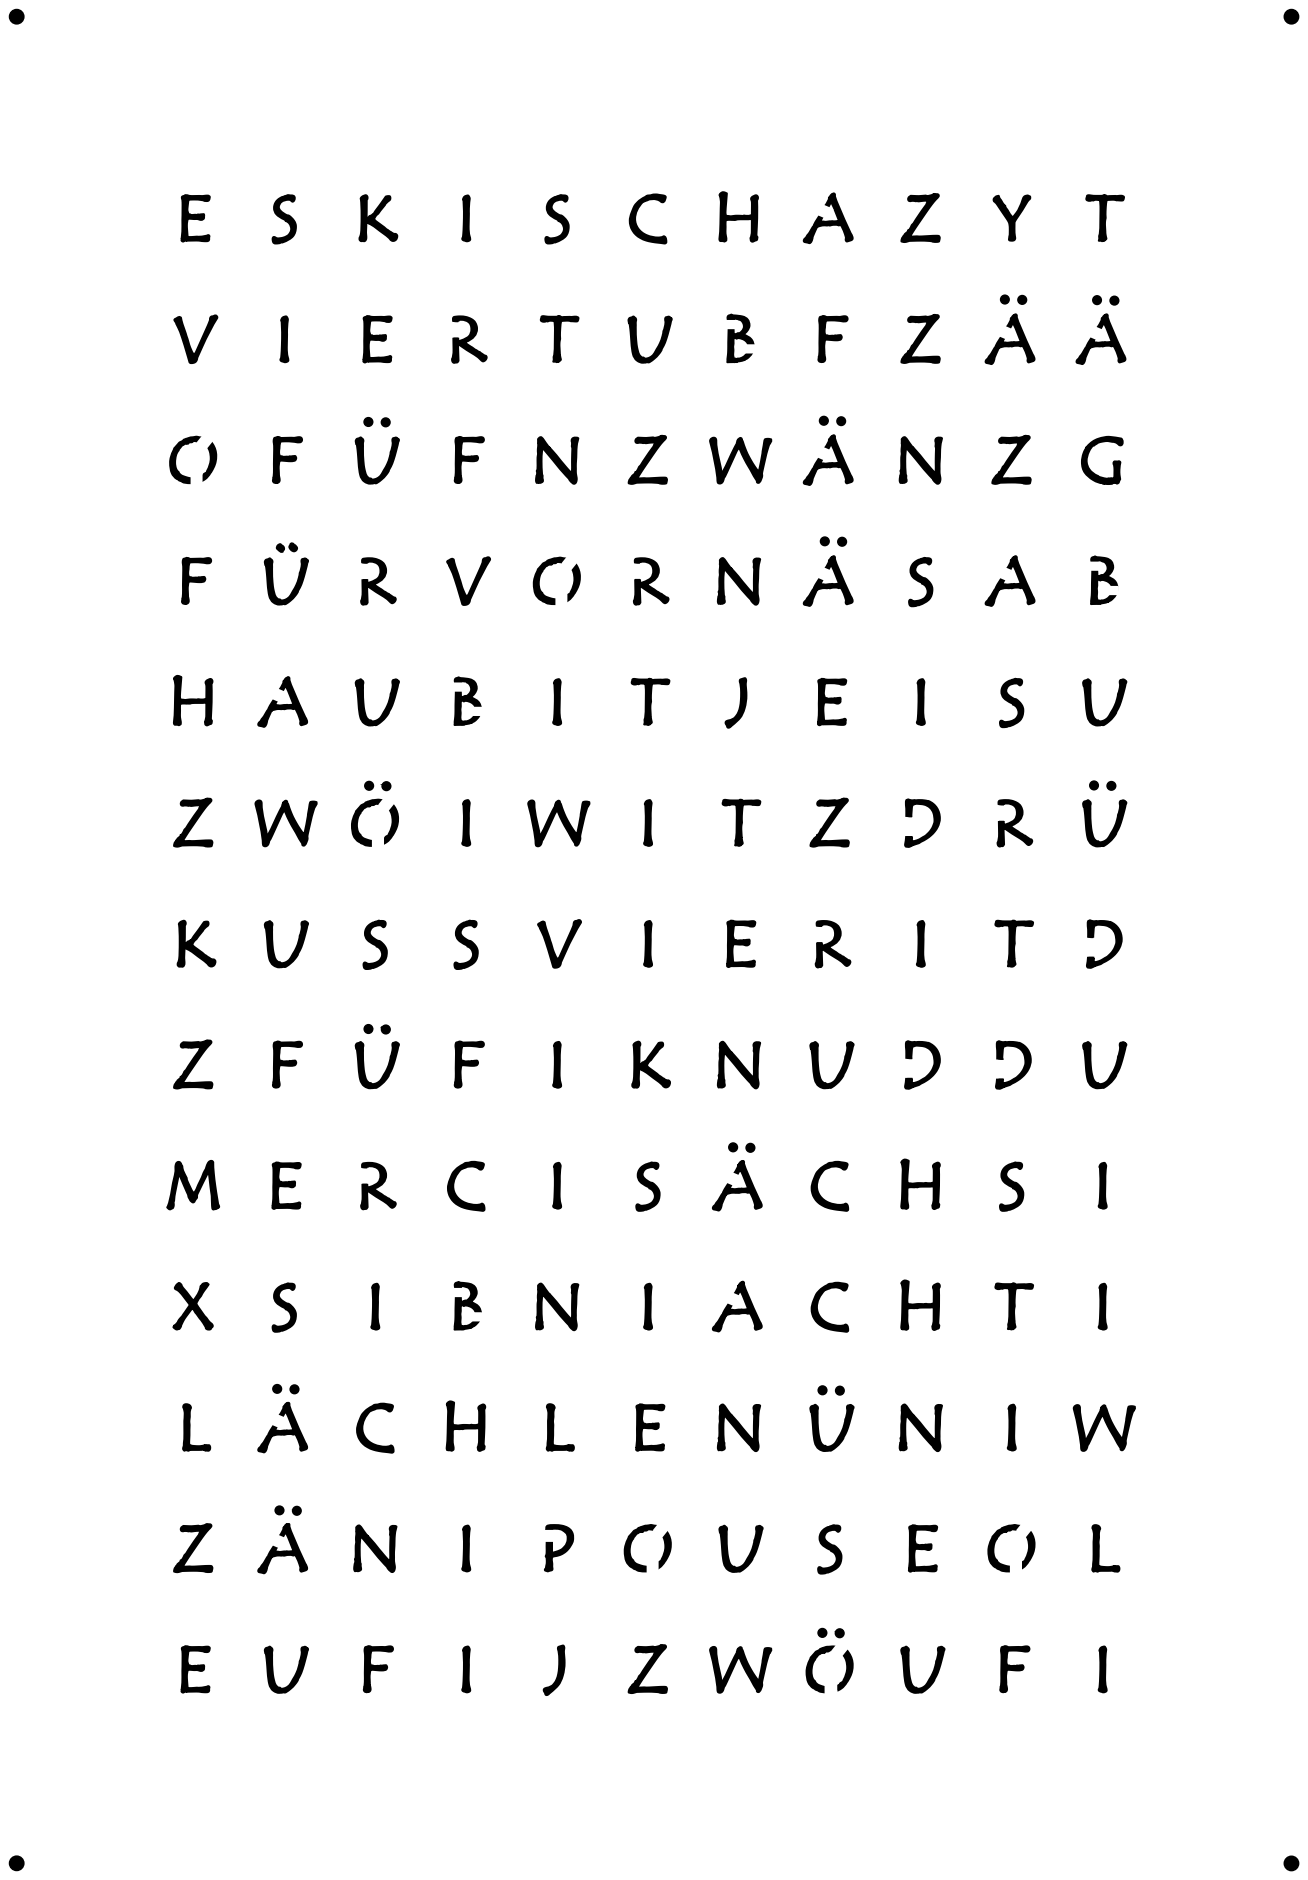
[picture p32: page 1]
