XaverBandi/Qlockthree_Eva_und_Xaver/Code/Anina_und_Ueli/Qlockthree/Qlockthree.ino

/**
 * Clockthree
 * Die Firmware der Selbstbau-QLOCKTWO.
 *
 * @mc       Arduino/RBBB (ATMEGA328)
 * @autor    Christian Aschoff / caschoff _AT_ mac _DOT_ com
 * @version  3.4.8
 * @created  1.11.2011
 * @updated  15.3.2015
 *
 * Versionshistorie:
 * V 1.1:   - DCF77 auf reine Zeit ohne Strings umgestellt.
 *          - Ganzes Datum wird in die DS1307 geschrieben (wieder verworfen).
 * V 1.2:   - Schnelles Schreiben der Shift-Register eingefuehrt.
 * V 1.3:   - Auf eigene DCF77-Bibliothek umgestellt (MyDCF77) und DCF77Helper verbessert.
 * V 1.4:   - Glimmen/Nachleuchten dank Tipp von Volker beseitigt (http://www.mikrocontroller.net/topic/209988).
 *          - Erneute Fehlerbereinigung in der DCF77-Bibliothek.
 * V 1.5:   - Die Helligkeit laesst sich ueber die Variable 'brightness' einstellen (Bereich 1-9) bzw.
 *              ueber den Compiler-Schalter 'ENABLE_LDR' die Regelung einschalten.
 * V 1.6:   - Fehler in der DCF77Helper-Bibliothek behoben.
 * V 1.7:   - SKIP_BLANK_LINES eingefuehrt, damit hellere LEDs (Danke an Johannes).
 * V 1.8:   - UPSIDE_DOWN eingefuehrt, damit man die Kabel beim Anoden-Multiplexer nicht kreuzen muss.
 * V 1.9:   - Diverse Verbesserungen und Fehlerbehebungen, die das Flackern drastisch reduzieren.
 * V 1.9.1: - Fehler behoben, der die Nutzung eines analogen Pins fuer den DCF77-Empfaenger verhindert hat.
 * V 1.9.2: - Timing-Parameter fuer die PWM ueber DEFINE anpassbar.
 *          - LDR-Grenzwerte automatisch anpassbar.
 *          - Schreibfehler in setHoures()->setHours() behoben.
 *          - Kompatibilitaet zu Arduino-IDE 1.0 hergestellt.
 * V 1.9.3: - Glimmen wieder behoben.
 * V 1.9.4: - Modus zum Einstellen der Helligkeit eingefuehrt.
 * V 2.0:   - Sprachrelevante Dinge ausgelagert, so kann man mehr Sprachen haben und einfach durch einkommentieren aktivieren.
 *          - setWords in setMinutes und setMinutes in setCorners umbenannt, weil es mehr Sinn ergibt.
 *          - setCorners in eigene Datei ausgelagert, weil viele Bastler sich vertun und in der Routine Aenderungen vornehmen muessen.
 *          - LDR in eigene Klasse ausgelagert und Werte geglaettet. Am Anfang werden 1000 Werte gelesen, damit er sich einpegelt.
 *          - Signal vom DCF77-Empfaenger geglaettet, damit nicht ein einzelner falscher Peak das Telegramm zerstoert.
 *          - Status-LEDs koennen ueber DEFINEs ausgeschaltet werden.
 *          - DCF77- und SQW-LED blinken am Anfang drei Mal als 'Hello', damit man ohne Serial-Monitor sehen kann, ob der ATMEGA anlaeuft.
 *          - Serial-Output ist immer an, kleine Statusmeldung waehrend der Initialisierung, damit man beim Bespielen des ATMEGA ohne weitere
 *              Elektronik sehen kann, ob das Programm drauf ist und laeuft.
 *          - Aenderung, die ein Stellen der Zeit nach dem DCF77-Signal auch im Modus 'BLANK' ermoeglicht - in diesem Modus ist der Empfang
 *              weniger gestoert, da die LED-Matrix abgeschaltet ist.
 *          - Zeitgesteuertes Abschalten des Displays eingefuehrt (Stromsparen in der Nacht/Schlafzimmer/besserer Empfang des DCF77-Empfaengers).
 *          - Speaker auf D13 eingefuehrt.
 *          - Alarm-Mode eingefuehrt.
 *          - Bayrische Sprachvariante (DE_BA): 'viertel nach Zehn', aber 'dreiviertel Elf'.
 * V 2.0.1: - DCF77-Tresholds angepasst.
 * V 2.0.2: - Strings in PROGMEM (flash) ausgelagert.
 * V 2.0.3: - SPEAKER_IS_BUZZER eingefuehrt, damit kann man sagen, ob man einen Lautsprecher oder Piezo-Buzzer als Alarm verwendet.
 * V 2.0.4: - falsches BREAK dank Lars behoben.
 * V 2.0.5: - Franzoesisch hinzugefuegt, Woerter_??.h's anschaulicher gemacht. Weitere Sprachen angelegt, aber noch nicht die Logik implementiert (Hilfe?!).
 * V 2.0.6: - cleanWordsForAlarmSettingMode() eingefuehrt, damit das Stellen des Alarms sprachenunabhaengig ist.
 *          - Das DCF77-Signal kann per Compiler-Schalter invertiert werden.
 * V 2.0.7: - Neuer Modus: Umschaltung LDR auto/manuell dank Alexander.
 * V 2.0.8: - Genauigkeit verbessert, dank Peter (Interrupt auf FALLING). @Peter: Das Zurueckscheiben in die DS1307 passiert im Normalbetrieb ja
                nur beim Update ueber den DCF77-Empfaenger, daher habe ich es weggelassen.
 * V 2.0.9: - SplitSideDown rausgenommen, diesen seltenen Fehler braucht kein Mensch.
 * V 2.1:   - Neue Sprachen hinzugefuegt: Englisch und Italiensch. Spanisch ist angelegt, aber nicht implementiert, weil ich kein Wort Spanisch spreche.
 *          - Man kann jetzt einfach relativ weit oben im Code ueber Compiler-Schalter festlegen, welche Sprache man haben moechte.
 * V 2.1.1: - Bitmaps in den PROGMEM ausgelagert. So kann man alle Buchstaben halten.
 * V 2.1.2: - Bug im Alaram-Modus behoben.
 * V 2.1.3: - Zusaetzlich zu den Ziffern auch Staben eingefuehrt, A/M-Modus darauf umgestellt (Vorbereitung auf Konfigurationsmoeglichkeit
 *              fuer alle Sprachen in einer Firmware)
 * V 2.1.4: - Optimierung hinsichtlich Speicherbedarf.
 * V 3.0:   - LedDriver-Klasse erstellt, welche die Shift-Register und UDN2981A als Led-Treiber kapseln. Dadurch kann man auch andere
 *              LED-Treiber nehmen (MAX7219, AS1130 etc.) und einfach eine passende Klasse von der LedDriver-Klasse vererben und in den Code einklinken.
 *          - Alle Sprachen im 'Renderer' zusammengefasst, so dass sie ohne die Firmware neu zu flashen umschaltbar werden.
 *          - Niederlaendisch hinzugefuegt (Danke an Wekog24 und Rudolf K.).
 *          - Eine kleine Debug-Klasse eingefuehrt, damit die #debug-Statements nicht so stark den Code zerhacken und er besser lesbar wird.
 *          - Beim Starten wird der freie Speicher und die Version auf der Console ausgegeben.
 *          - Eine Alarm-Klasse eingefuehrt, das macht den 'Hauptcode' nochmal besser lesbar.
 *          - Configuration.h eingefueht, in der alle wichtigen Compiler-Schalter zusammengefuehrt sind, dadurch gibt es eine zentrale Stelle
 *              fuer die Anpassungen (Danke fuer das Konzept an Markus K.).
 *          - Settings.h eingefuehrt, in der die Spracheinstellung gehalten wird und im EEPROM gespeichert wird (Danke fuer das Konzept an Markus K.).
 *          - Modes zum Einstellen der Sprache und des Eck-Modus eingefuehrt.
 *          - Extended Modes eingefuehrt.
 *          - Saechsisch als Sprache aufgenommen, danke an Sven.
 *          - Bug im setzten der Eck-LEDs fuer den Ueberpixel behoben.
 *          - Brightness ist normaler Mode, aber nur wenn ldr_auto == FALSE.
 *          - Automatische Alarm-Abschaltung nach MAX_BUZZ_TIME_IN_MINUTES.
 *          - Stellen der Uhr nur im erweiterten Modus moeglich (sonst verstellt man sie leicht bei der Verwendung als Wecker).
 *          - LDR-Modus wird im EEPROM abgelegt.
 *          - kleinere Korrekturen, die nur in erweiterten Compiler-Ausgaben zu Warnings gefuehrt haben.
 *          - Kleinere Optimierungen, Danke an Michael K.
 *          - Bug aufgrund eines moeglichen Ueberlaufs von millis() in Button.cpp behoben.
 *          - Verbesserungen in der Helligkeitssteuerung.
 *          - ENABLE_LDR aus Configuration.h entfernt, da sich der LDR ueber das erweiterte Setup ausschalten laesst.
 * V 3.0.1: - Schweizer Layout angepasst.
 * V 3.1:   - Spanisch implementiert.
 *          - Der LDR skaliert jetzt selbst, dann flackert es weniger bei unguenstigen Lichtverhaeltnissen.
 * V 3.1.1. - Die Displayhelligkeit wird beim starten gesetzt.
 *          - Kleiner Fehler im Spanischen behoben.
 *          - Die alte Shiftregistermethode ist wieder aktiv, die schnelle kann in Configuration.h gesetzt werden.
 * V 3.1.2. - Led-Driver-Klassen sagen, wer sie sind (fuer die Ausgabe der Konfiguration beim Start).
 *          - Klassen-Namen verbessert.
 * V 3.2.   - Led-Driver fuer das Licht-Monster implementiert.
 *          - LDR-Klasse auf 0-100% umgebaut.
 *          - Brightness wird im EEPROM gesichert.
 *          - EnableAlarm und DCF77SignalIsInverted ins EEPROM ausgelagert und ueber das erweiterte Setup einstellbar.
 *          - Die Modi SCRAMBLE und ALL entfernt, dafuer den Modus TEST eingefuehrt. ALL ist fuer manche DisplayDriver gefaehrlich wegen des Stromverbrauchs. TEST schalte nacheinander alle LEDs einmal durch.
 *          - Moeglichkeit zur Zeitverschiebung eingefuehrt.
 * V 3.2.1. - Alle Deutsch-Varianten zusammengefasst, um Platz zu sparen.
 *          - Fehler im Italienischen behoben.
 *          - Fehler mit Doppelbelegung einer Variable im Qlockthree.ino behoben.
 *          - Der LDR wird nur alle 250ms gelesen, dann flackert er weniger bei unguenstigen Verhaeltnissen.
 * V 3.2.2. - DS1307 Multi-MCU-Faehig gemacht.
 *          - Initialisierung der DS1307 verbessert.
 * V 3.2.3. - A0-Hack: Verbindet man die freie A0-Leitung mit PON vom DCF77-Empfaenger, schaltet diese den Empfaenger korrekt
 *              ein und aus, je nach Displayzustand. Ist PON fest mit GND verbunden, passiert nichts (schadet aber auch  nicht).
 * V 3.2.4. - Der DCF-Empfaenger wird ueber A0 am Anfang eingeschaltet, dann nicht mehr ausgeschaltet.
 *          - Wird in den Blank-Modus geschaltet (Display aus), schaltet sich nach dem erfolgreichen Empfang der Zeit ueber DCF77
 *              das Display wieder ein (hilft beim Debuggen).
 *          - Der Nachtabschaltmodus ist ein eigener, nicht manuell erreichbarer Modus.
 * V 3.3.0. - LedDriverNeoPixel fuer den Aufbau mit WS2812B-Streifen eingefuehrt (Verkabelungsschema ist beim LedDriverNeoPixel)...
 *          - ...dazu die Klasse Button angepasst, so dass sie auch gegen GND schalten kann (damit Unterstuetzung fuer das BBRTCAD).
 *          - Achtung! Wenn die NeoPixel-Library im Librarys-Ordner ist, kann ich keinen Pointer auf den Stripe (in LedDriverNeoPixel.h)
 *              definieren (ich weiss leider nicht warum, es kommt eine seltsame Compiler-Meldung). Wenn sie im Qlockthree-Ordner ist, geht es.
 *          - IR-Fernbedienungs-Unterstuetzung eingefuehrt. Achtung! Wegen Platzmangels alle IRs ausser der Sparkfun (NEC) auskommentiert. Siehe weitere
 *              Infos weiter unten und bei der IR-Fernbedienung!
 *          - Achtung! Weil ich die IR-Receiver-Library (https://github.com/shirriff/Arduino-IRremote/) entschlacken musste, ist sie hier
 *              im Qlockthree-Ordner. Wenn sie auch im Librarys-Ordner ist, schlaegt die Compilierung fehl! Wer andere Codes als die von der
 *              SparkFun-Fernbedienung (NEC) nehmen mechte, muss die entsprechenden Typen in der Datei IRremote.cpp so ab Zeile 427 wieder
 *              einkommentieren. Die Implementierung hier ist beispielhaft zu sehen, um eigene Ideen verwirklichen zu koennen.
 *          - Test-Modus geaendert, damit er mit der IR-Fernbedienung klappt. Die Eck-LEDs zaehlen im Sekunden-Takt hoch, die Spalten werden
 *              im Sekunden-Takt nach rechts durchgeschaltet.
 *          - DCF-Empfang verbessert, dank Tipp aus dem Forum (unguenstiger INTERNAL_PULLUP beim Signal-Pin; PULL-Widerstaende muessen in Hardware
 *              je nach verwendetem Empfaenger realisiert werden).
 *          - Flackern in Ext-Menues und Manual-Brightness behoben, falsch durchdachtes linesToWrite-Statement (interessiert nur DefaultLedDriver,
 *              alle anderen ignorieren es eh).
 *          - Fehler in der DS1307-Klasse behoben. Nicht immer kommen die angeforderten 7 Bytes, dann verwerfen und neu anfordern (und nach
 *              8 Versuchen abbrechen). Der I2C-Bus ist wohl speziell bei LED-Stripes gerne mal gestoert, dann kommen die beruehmten '85' Sekunden.
 *          - Mode fuer die Visualisierung des DCF77-Empfangs (im Ext-Menue nach dem LED-Test) eingefuehrt. Man kann damit abschaetzen, wie gut der
 *              DCF77-Empfang ist. Mit der gelben LED muessen die Ecken durchschalten. Schalten sie wild durcheinander, gibt es Fehlsignale.
 *              Das Problem ist, dass ja die LED-Matrix den Empfang stoert. So stoert natuerlich potentiell auch die Visualisierung den Empfang.
 *              Mit einem WortWecker hat das dennoch ganz gut geklappt. Mit dem experimentellen LedDriverNeoPixel nicht.
 *          - Kleinen Fehler im Italienischen behoben, danke an die diversen Hinweisgeber!
 * V 3.3.1. - Stundenbegrenzung im Renderer (die ja wegen der Zeitverschiebungsmoeglichkeit existiert) auf den Bereich 0 <= h <= 24 ausgeweitet,
 *              dank Tipp aus dem Forum.
 * V 3.4.0. - Die DCF77-Decoding-Klasse vollstaendig umgestellt. Alle Beispiele im Internet gehen davon aus, dass man keine Vergleichszeit hat.
 *              Da wir hier eine Echtzeituhr haben, kann man statistische Methoden zur Auswertung verwenden. Wenn das Signal optisch brauchbar aussieht (gelbe LED),
 *              Synchronisiert die Zeit in weniger als 4 Minuten. Aber es muss eben brauchbar aussehen. Kurzes Aufblinken 1 Mal pro Sekunde, eine
 *              Pause pro Minute.
 * V 3.4.1. - Die Adafruit- und IR-Library umbenannt ("My" vorangestellt), damit sie nicht mit den offiziellen Librarys kollidieren. Warum sie hier lokal liegen,
 *              steht weiter oben.
 * V 3.4.2. - LDR-Bugs behoben und -Klasse optimiert. Dazu auch Getter fuer die Helligkeit in den Display-Drivern eingefuehrt.
 * V 3.4.3. - Vergessene DEBUGs auskommentiert, Check der DS1307 beim Start verbessert (Danke an Erich M.).
 * V 3.4.4. - Verbesserungen in der RTC (setzten der Zeit durch Compile-Zeit moeglich).
 *          - Adafruits NeoPixel-Library muss jetzt im Librarys-Ordner liegen.
 * V 3.4.5. - DS1307 nach MyRTC umbenannt, weil es nicht mehr nur um die DS1307 geht.
 *          - Einschalten des Rechtecksignals fuer DS1307 und DS3231 getrennt (Danke an Erich M.) - Konfiguration in der Configuration.h.
 *          - Unterstuetzung verschiedener IR-Fernbedienungen vereinfacht. Codes von NEC-compatiblen Fernbedienungen werden angezeigt, wenn eine Fernbedienung in
 *              der Configuration.h eingeschaltet ist (muss nicht die richtige sein) und #DEBUG an ist. Drei Beispiel-Remotes sind angelegt: Sparkfun,
 *              Mooncandles, Lunartec. Bei der Verwendung von Nicht-NEC-Fernbedienungen muss der entsprechende Part in MyIRremote.cpp einkommentiert werden,
 *              ein guter Start ist Zeile 428.
 *          - Im Zusammenhang mit den Fernbedienungen setColor() fuer die LED-Driver eingefuehrt. Damit kann man die Farben von RGB-Stripes aendern. Bei
 *              dem klassischen Aufbau mit einfarbeigen LEDs (75HC595; MAX7219 etc.) passiert natuerlich nichts.
 *          - Unterstuetzung fuer APA102-Stripes (DotStars) eingefuehrt, die Adafruit APA102-Library muss dazu im librarys-Ordner liegen.
 *          - FPS werden bei eingeschaltetem #DEBUG angezeigt.
 *          - Die Helligkeitsregelung laeuft jetzt sanfter. Timing-Werte fuer die verschiedenen LedDriver in der Configuration.h hinterlegt.
 * V 3.4.6. - Unterstuetzung fuer LPD8806-Stripes eingefuehrt, die Adafruit LPD8806-Library muss dazu im librarys-Ordner liegen. Achtung! Zur Zeit hat die LPD8806-Library
 *              von Adafruit einen Bug. Es fehlt das klassische #ifndef __CLASSNAME__ #define __CLASSNAME__ [Klasssendefinition] #endif um die Klasse im .h-File.
 * V 3.4.7. - Unterstuetzung fuer Buttons auf rein analoge Ports hinzugefuegt, wie sie der ATMEGA328 in SMD-Ausfuehrung hat.
 *          - Unterstuetzung fuer die alte Arduino-IDE (bis 1.0.6) entfernt, da sich die Firmware damit eh nicht mehr kompilieren laesst.
 *          - Library fuer MAX7219 (LedControl) ausgelagert, sie muss jetzt im Librarys-Ordner liegen.
 * V 3.4.8. - HelperSeconds-Behandlung in Interrupt-Funktion verschoben, damit die nicht aufgrund von Tastendruecken hochgezaehlt werden, danke an Meikel.
 */
#include <Wire.h> // Wire library fuer I2C
#include <avr/pgmspace.h>
#include <EEPROM.h>
#include <SPI.h>
#include <LedControl.h>
#include <Adafruit_NeoPixel.h>
#include <Adafruit_DotStar.h>
#include <LPD8806.h>
#include "Configuration.h"
#include "LedDriver.h"
#include "LedDriverDefault.h"
#include "LedDriverUeberPixel.h"
#include "LedDriverPowerShiftRegister.h"
#include "LedDriverNeoPixel.h"
#include "LedDriverDotStar.h"
#include "LedDriverLPD8806.h"
#include "IRTranslator.h"
#include "IRTranslatorSparkfun.h"
#include "IRTranslatorMooncandles.h"
#include "IRTranslatorLunartec.h"
#include "MyIRremote.h"
#include "MyRTC.h"
#include "MyDCF77.h"
#include "Button.h"
#include "AnalogButton.h"
#include "LDR.h"
#include "DCF77Helper.h"
#include "Renderer.h"
#include "Staben.h"
#include "Alarm.h"
#include "Settings.h"
#include "Zahlen.h"

#define FIRMWARE_VERSION "V 3.4.8 vom 15.3.2015"

/*
 * Den DEBUG-Schalter gibt es in allen Bibiliotheken. Wird er eingeschaltet, werden ueber den
 * 'Serial-Monitor' der Arduino-Umgebung Informationen ausgegeben. Die Geschwindigkeit im
 * Serial-Monitor muss mit der hier angegeben uebereinstimmen.
 * Default: ausgeschaltet
 */
#define DEBUG
#include "Debug.h"
// Die Geschwindigkeit der seriellen Schnittstelle. Default: 57600. Die Geschwindigkeit brauchen wir immer,
// da auch ohne DEBUG Meldungen ausgegeben werden!
#define SERIAL_SPEED 57600

/*
 * Die persistenten (im EEPROM gespeicherten) Einstellungen.
 */
Settings settings;

/**
 * Hier definiert man die Ab- und Anschaltzeiten fuer das Display. Die Abschaltung des
 * Displays verbessert den Empfang des DCF77-Empfaengers. Und hilft, falls die Uhr im
 * Schlafzimmer haengt.
 * Sind alle Werte auf 0 wird das Display nie abgeschaltet. Nach einer Minute kann man das
 * Display manuell wieder ein- / ausschalten.
 * Achtung! Wenn sich die Uhr nachmittags abschaltet ist sie in der falschen Tageshaelfte!
 */
// um 3 Uhr Display abschalten (Minuten, Stunden, -, -, -, -)
TimeStamp offTime(0, 0, 0, 0, 0, 0);
// um 4:30 Uhr Display wieder anschalten (Minuten, Stunden, -, -, -, -)
TimeStamp onTime(0, 0, 0, 0, 0, 0);

/**
 * Der Renderer, der die Woerter auf die Matrix ausgibt.
 */
Renderer renderer;

/**
 * Der LED-Treiber fuer 74HC595-Shift-Register. Verwendet
 * von der Drei-Lochraster-Platinen-Version und dem
 * NachBau_V02-Board sowie dem WortWecker nach Christian.
 *
 * Data: 10; Clock: 12; Latch: 11; OutputEnable: 3
 * LinesToWrite: 13
 */
#ifdef LED_DRIVER_DEFAULT
LedDriverDefault ledDriver(10, 12, 11, 3, 13);

#define PIN_MODE 7
#define PIN_M_PLUS 5
#define PIN_H_PLUS 6

#define BUTTONS_PRESSING_AGAINST HIGH

#define PIN_IR_RECEIVER A1

#define PIN_LDR A3
#define IS_INVERTED true

#define PIN_SQW_SIGNAL 2
#define PIN_DCF77_SIGNAL 9

#define PIN_DCF77_PON A0

#define PIN_SQW_LED 4
#define PIN_DCF77_LED 8

#define PIN_SPEAKER 13
#endif

/**
 * Der LED-Treiber fuer 4 MAX7219-Treiber wie im Ueberpixel.
 * Data: 10; Clock: 11; Load: 12
 */
#ifdef LED_DRIVER_UEBERPIXEL
LedDriverUeberPixel ledDriver(5, 6, 7);

#define PIN_MODE 8
#define PIN_M_PLUS 3
#define PIN_H_PLUS 4

#define BUTTONS_PRESSING_AGAINST HIGH

#define PIN_IR_RECEIVER A1

#define PIN_LDR A3
#define IS_INVERTED true

#define PIN_SQW_SIGNAL 2
#define PIN_DCF77_SIGNAL 9

#define PIN_DCF77_PON A0

#define PIN_SQW_LED 10
#define PIN_DCF77_LED 11

#define PIN_SPEAKER 13
#endif

/**
 * Der LED-Treiber fuer Power-Shift-Register.
 * Data: 10; Clock: 11; Load: 12
 */
#ifdef LED_DRIVER_POWER_SHIFT_REGISTER
LedDriverPowerShiftRegister ledDriver(10, 12, 11, 3);

#define PIN_MODE 7
#define PIN_M_PLUS 5
#define PIN_H_PLUS 6

#define BUTTONS_PRESSING_AGAINST HIGH

#define PIN_IR_RECEIVER A1

#define PIN_LDR A3
#define IS_INVERTED true

#define PIN_SQW_SIGNAL 2
#define PIN_DCF77_SIGNAL 9

#define PIN_DCF77_PON A0

#define PIN_SQW_LED -1
#define PIN_DCF77_LED -1

#define PIN_SPEAKER -1
#endif

/**
 * Der LED-Treiber fuer NeoPixel-Stripes an einem BBRTCAD.
 * Data: 6
 */
#ifdef LED_DRIVER_NEOPIXEL
LedDriverNeoPixel ledDriver(6);

#define PIN_MODE 11
#define PIN_M_PLUS 13
#define PIN_H_PLUS 12

#define BUTTONS_PRESSING_AGAINST LOW

#define PIN_IR_RECEIVER A1

#define PIN_LDR A0
#define IS_INVERTED true

#define PIN_SQW_SIGNAL 2
#define PIN_DCF77_SIGNAL 3

#define PIN_DCF77_PON 4

#define PIN_SQW_LED 9
#define PIN_DCF77_LED 10

#define PIN_SPEAKER -1
#endif

/**
 * Der LED-Treiber fuer DotStars-Stripes an einem BBRTCAD.
 * Data: 6
 * Clock: 7
 */
#ifdef LED_DRIVER_DOTSTAR
LedDriverDotStar ledDriver(6, 7);

#define PIN_MODE 11
#define PIN_M_PLUS 13
#define PIN_H_PLUS 12

#define BUTTONS_PRESSING_AGAINST LOW

#define PIN_IR_RECEIVER A1

#define PIN_LDR A0
#define IS_INVERTED false

#define PIN_SQW_SIGNAL 2
#define PIN_DCF77_SIGNAL 3

#define PIN_DCF77_PON 4

#define PIN_SQW_LED 9
#define PIN_DCF77_LED 10

#define PIN_SPEAKER -1
#endif

/**
 * Der LED-Treiber fuer LPD8806-Stripes an einem BBRTCAD.
 * Data: 6
 * Clock: 7
 */
#ifdef LED_DRIVER_LPD8806
LedDriverLPD8806 ledDriver(6, 7);

#define PIN_MODE 11
#define PIN_M_PLUS 13
#define PIN_H_PLUS 12

#define BUTTONS_PRESSING_AGAINST LOW

#define PIN_IR_RECEIVER A1

#define PIN_LDR A0
#define IS_INVERTED false

#define PIN_SQW_SIGNAL 2
#define PIN_DCF77_SIGNAL 3

#define PIN_DCF77_PON 4

#define PIN_SQW_LED 9
#define PIN_DCF77_LED 10

#define PIN_SPEAKER -1
#endif

/**
 * Der IR-Remote-Control-Receiver.
 */
#ifndef REMOTE_NO_REMOTE
IRrecv irrecv(PIN_IR_RECEIVER);
decode_results irDecodeResults;
#endif
#ifdef REMOTE_SPARKFUN
IRTranslatorSparkfun irTranslator;
#endif
#ifdef REMOTE_MOONCANDLES
IRTranslatorMooncandles irTranslator;
#endif
#ifdef REMOTE_LUNARTEC
IRTranslatorLunartec irTranslator;
#endif

/**
 * Die Real-Time-Clock mit der Status-LED fuer das SQW-Signal.
 */
MyRTC rtc(0x68, PIN_SQW_LED);
volatile byte helperSeconds;

/**
 * Der Funkempfaenger (DCF77-Signal der PTB Braunschweig).
 */
MyDCF77 dcf77(PIN_DCF77_SIGNAL, PIN_DCF77_LED);
DCF77Helper dcf77Helper;

/**
 * Variablen fuer den Alarm.
 */
Alarm alarm(PIN_SPEAKER);

/**
 * Der Helligkeitssensor
 */
LDR ldr(PIN_LDR, IS_INVERTED);
unsigned long lastBrightnessCheck;

/**
 * Die Helligkeit zum Anzeigen mit den Balken.
 */
byte brightnessToDisplay;

/**
 * Die Tasten.
 */
Button minutesPlusButton(PIN_M_PLUS, BUTTONS_PRESSING_AGAINST);
Button hoursPlusButton(PIN_H_PLUS, BUTTONS_PRESSING_AGAINST);
Button extModeDoubleButton(PIN_M_PLUS, PIN_H_PLUS, BUTTONS_PRESSING_AGAINST);
Button modeChangeButton(PIN_MODE, BUTTONS_PRESSING_AGAINST);

/**
 * Die Standard-Modi.
 */
#define STD_MODE_NORMAL     0
#define STD_MODE_ALARM      1
#define STD_MODE_SECONDS    2
#define STD_MODE_BRIGHTNESS 3
#define STD_MODE_BLANK      4
#define STD_MODE_COUNT      4
// nicht manuell zu erreichender Modus...
#define STD_MODE_NIGHT      7

/**
 * Die erweiterten Modi.
 */
#define EXT_MODE_START           10
#define EXT_MODE_LDR_MODE        10
#define EXT_MODE_CORNERS         11
#define EXT_MODE_ENABLE_ALARM    12
#define EXT_MODE_DCF_IS_INVERTED 13
#define EXT_MODE_LANGUAGE        14
#define EXT_MODE_TIMESET         15
#define EXT_MODE_TIME_SHIFT      16
#define EXT_MODE_TEST            17
#define EXT_MODE_DCF_DEBUG       18
#define EXT_MODE_COUNT           18

// Startmode...
byte mode = STD_MODE_NORMAL;
// Merker fuer den Modus vor der Abschaltung...
byte lastMode = mode;

// Ueber die Wire-Library festgelegt:
// Arduino analog input 4 = I2C SDA
// Arduino analog input 5 = I2C SCL

// Die Matrix, eine Art Bildschirmspeicher
word matrix[16];

// Hilfsvariable, da I2C und Interrupts nicht zusammenspielen
volatile boolean needsUpdateFromRtc = true;

// Fuer den Bildschirm-Test
byte x, y;

// Fuer fps-Anzeige
word frames = 0;
unsigned long lastFpsCheck = 0;

/**
 * Aenderung der Anzeige als Funktion fuer den Interrupt, der ueber das SQW-Signal
 * der Real-Time-Clock gesetzt wird. Da die Wire-Bibliothek benutzt wird, kann man
 * den Interrupt nicht direkt benutzen, sondern muss eine Hilfsvariable setzen, die
 * dann in loop() ausgewertet wird.
 */
void updateFromRtc() {
  needsUpdateFromRtc = true;
  // die Zeit verursacht ein kurzes Flackern. Wir muessen
  // sie aber nicht immer lesen, im Modus 'normal' alle 60 Sekunden,
  // im Modus 'seconds' alle Sekunde, sonst garnicht.
  helperSeconds++;
  if (helperSeconds >= 60) {
    helperSeconds = 0;
  }
}

/**
 * Den freien Specher abschaetzen.
 * Kopiert von: http://playground.arduino.cc/Code/AvailableMemory
 */
int freeRam() {
  extern int __heap_start, *__brkval;
  int v;
  return (int) &v - (__brkval == 0 ? (int) &__heap_start : (int) __brkval);
}

/**
 * Initialisierung. setup() wird einmal zu Beginn aufgerufen, wenn der
 * Arduino Strom bekommt.
 */
void setup()
{
  Serial.begin(SERIAL_SPEED);
  Serial.println(F("Qlockthree is initializing..."));
  DEBUG_PRINTLN(F("... and starting in debug-mode..."));
  Serial.flush();

  pinMode(PIN_DCF77_PON, OUTPUT);
  enableDcf(false);

  if (settings.getEnableAlarm()) {
    // als Wecker Display nicht abschalten...
    TimeStamp offTime(0, 0, 0, 0, 0, 0);
    TimeStamp onTime(0, 0, 0, 0, 0, 0);
  }

  // LED-Treiber initialisieren
  ledDriver.init();
  // Inhalt des Led-Treibers loeschen...
  ledDriver.clearData();
  // und Inhalt des Bildspeichers loeschen
  renderer.clearScreenBuffer(matrix);
  // wir brauchen nur 10 Zeilen...
  ledDriver.setLinesToWrite(13);

  // starte Wire-Library als I2C-Bus Master
  Wire.begin();

  // RTC-Interrupt-Pin konfigurieren
  pinMode(PIN_SQW_SIGNAL, INPUT);
  digitalWrite(PIN_SQW_SIGNAL, HIGH);

  // DCF77-LED drei Mal als 'Hello' blinken lassen
  // und Speaker piepsen kassen, falls ENABLE_ALARM eingeschaltet ist.
  for (byte i = 0; i < 3; i++)
  {
    dcf77.statusLed(true);
    if (settings.getEnableAlarm())
    {
      alarm.buzz(true);
    }
    delay(100);
    dcf77.statusLed(false);
    if (settings.getEnableAlarm())
    {
      alarm.buzz(false);
    }
    delay(100);
  }

  Serial.print(F("Compiled: "));
  Serial.print(F(__TIME__));
  Serial.print(F(" / "));
  Serial.println(F(__DATE__));

  /*
  // Uhrzeit nach Compile-Zeit stellen...
  rtc.set(__DATE__, __TIME__);
  rtc.writeTime();
   */

  // RTC starten...
  rtc.readTime();
  if ((rtc.getSeconds() >= 60) || (rtc.getMinutes() >= 60) || (rtc.getHours() >= 24) || (rtc.getYear() < 15))
  {
    // Echtzeituhr enthaelt Schrott, neu mit erkennbaren Zahlen beschreiben...
    DEBUG_PRINT(F("Resetting RTC..."));
    rtc.setHours(8);
    rtc.setMinutes(30);
    rtc.setSeconds(10);
    rtc.setYear(15);
    rtc.setMonth(9);
    rtc.setDate(9);
    rtc.setDayOfWeek(3);
  }

#ifdef DS1307
  Serial.println(F("Uhrentyp ist DS1307."));
  rtc.enableSQWOnDS1307();
#elif defined DS3231
  Serial.println(F("Uhrentyp ist DS3231."));
  rtc.enableSQWOnDS3231();
#else
  Definition_des_Uhrtyps_fehlt!
  In der Configuration.h muss der Uhrentyp angegeben werden!
#endif

  rtc.writeTime();
  helperSeconds = rtc.getSeconds();
  Serial.print(F("RTC-Time: "));
  Serial.print(rtc.getHours());
  Serial.print(F(":"));
  Serial.print(rtc.getMinutes());
  Serial.print(F(":"));
  Serial.print(rtc.getSeconds());
  Serial.print(F(" RTC-Date: "));
  Serial.print(rtc.getDate());
  Serial.print(F("."));
  Serial.print(rtc.getMonth());
  Serial.print(F("."));
  Serial.println(rtc.getYear());

  // Den Interrupt konfigurieren,
  // nicht mehr CHANGE, das sind 2 pro Sekunde,
  // RISING ist einer pro Sekunde, das reicht.
  // Auf FALLING geandert, das signalisiert
  // den Sekundenwechsel, Danke an Peter.
  attachInterrupt(0, updateFromRtc, FALLING);

  // Werte vom LDR einlesen und vermuellen, da die ersten nichts taugen...
  for (int i = 0; i < 1000; i++) {
    analogRead(PIN_LDR);
  }

  // rtcSQWLed-LED drei Mal als 'Hello' blinken lassen
  // und Speaker piepsen kassen, falls ENABLE_ALARM eingeschaltet ist.
  for (byte i = 0; i < 3; i++) {
    rtc.statusLed(true);
    if (settings.getEnableAlarm()) {
      alarm.buzz(true);
    }
    delay(100);
    rtc.statusLed(false);
    if (settings.getEnableAlarm()) {
      alarm.buzz(false);
    }
    delay(100);
  }

  // ein paar Infos ausgeben
  Serial.println(F("... done and ready to rock!"));

  Serial.print(F("Version: "));
  Serial.println(F(FIRMWARE_VERSION));

  Serial.print(F("Driver: "));
  ledDriver.printSignature();

#ifndef REMOTE_NO_REMOTE
  Serial.print(F("Remote: "));
  irTranslator.printSignature();
  irrecv.enableIRIn();
#else
  Serial.print(F("Remote: disabled."));
#endif

  if (settings.getEnableAlarm()) {
    Serial.println(F("Alarm is enabled"));
  }

  if (settings.getDcfSignalIsInverted()) {
    Serial.println(F("DCF77-Signal is inverted."));
  }

  Serial.print(F("Free ram: "));
  Serial.print(freeRam());
  Serial.println(F(" bytes."));

  Serial.flush();

  // DCF77-Empfaenger einschalten...
  enableDcf(true);
  // Display einschalten...
  ledDriver.wakeUp();
  ledDriver.setBrightness(settings.getBrightness());
}

/**
 * loop() wird endlos auf alle Ewigkeit vom Microcontroller durchlaufen
 */
void loop()
{
  //
  // FPS
  //
#ifdef DEBUG
  frames++;
  if (lastFpsCheck > millis())
  {
    lastFpsCheck = millis();
  }
  if (lastFpsCheck + 1000 < millis())
  {
    DEBUG_PRINT("FPS: ");
    DEBUG_PRINTLN(frames);
    lastFpsCheck = millis();
    frames = 0;
  }
#endif

  //
  // Dimmung.
  //
  /* von Xaver auskommandiert
  if (settings.getUseLdr()) {
    if (millis() < lastBrightnessCheck) {
      // wir hatten einen Ueberlauf...
      lastBrightnessCheck = millis();
    }
    if (lastBrightnessCheck + LDR_CHECK_RATE < millis()) { // langsam nachsehen...
      byte lv = ldr.value();
      if (ledDriver.getBrightness() > lv) {
        ledDriver.setBrightness(ledDriver.getBrightness() - 1);
      } else if (ledDriver.getBrightness() < lv) {
        ledDriver.setBrightness(ledDriver.getBrightness() + 1);
      }
      lastBrightnessCheck = millis();
    }
  }
  */

  //
  // needsUpdateFromRtc wird via Interrupt gesetzt ueber fallende
  // Flanke des SQW-Signals von der RTC.
  // Oder falls eine Tasten-Aktion eine sofortige Aktualisierung des Displays braucht.
  //
  if (needsUpdateFromRtc)
  {
    //DEBUG_PRINT("We need a update from RTC!, by Xaveer\n");
    needsUpdateFromRtc = false;
    if (dcf77.newSecond()) {
      manageNewDCF77Data();
    }

    //
    // Zeit einlesen...
    //
    switch (mode) {
      case STD_MODE_NORMAL:
      case EXT_MODE_TIMESET:
      case STD_MODE_ALARM:
        if (alarm.isActive()) {
          rtc.readTime();
        }
        if (helperSeconds == 0) {
          rtc.readTime();
          helperSeconds = rtc.getSeconds();
        }
        break;
      case STD_MODE_SECONDS:
      case STD_MODE_BLANK:
      case STD_MODE_NIGHT:
        rtc.readTime();
        helperSeconds = rtc.getSeconds();
        break;
        // andere Modi egal...
    }

    //
    // Bildschirmpuffer beschreiben...
    //
    switch (mode) {
      case STD_MODE_NORMAL:
      case EXT_MODE_TIMESET:
        renderer.clearScreenBuffer(matrix);
        renderer.setMinutes(rtc.getHours() + settings.getTimeShift(), rtc.getMinutes(), settings.getLanguage(), matrix);
        renderer.setCorners(rtc.getMinutes(), settings.getRenderCornersCw(), matrix);
        break;
      case EXT_MODE_TIME_SHIFT:
        renderer.clearScreenBuffer(matrix);
        if (settings.getTimeShift() < 0) {
          for (byte x = 0; x < 3; x++) {
            ledDriver.setPixelInScreenBuffer(x, 1, matrix);
          }
        } else if (settings.getTimeShift() > 0) {
          for (byte x = 0; x < 3; x++) {
            ledDriver.setPixelInScreenBuffer(x, 1, matrix);
          }
          for (byte y = 0; y < 3; y++) {
            ledDriver.setPixelInScreenBuffer(1, y, matrix);
          }
        }
        for (byte i = 0; i < 7; i++) {
          matrix[3 + i] |= pgm_read_byte_near(&(ziffern[abs(settings.getTimeShift()) % 10][i])) << 5;
          if (abs(settings.getTimeShift()) > 9) {
            matrix[3 + i] |= pgm_read_byte_near(&(ziffern[1][i])) << 10;
          }
        }
        break;
      case STD_MODE_ALARM:
        renderer.clearScreenBuffer(matrix);
        if (alarm.getShowAlarmTimeTimer() == 0) {
          renderer.setMinutes(rtc.getHours() + settings.getTimeShift(), rtc.getMinutes(), settings.getLanguage(), matrix);
          renderer.setCorners(rtc.getMinutes(), settings.getRenderCornersCw(), matrix);
          matrix[4] |= 0b0000000000011111; // Alarm-LED
        } else {
          renderer.setMinutes(alarm.getAlarmTime()->getHours() + settings.getTimeShift(), alarm.getAlarmTime()->getMinutes(), settings.getLanguage(), matrix);
          renderer.setCorners(alarm.getAlarmTime()->getMinutes(), settings.getRenderCornersCw(), matrix);
          renderer.cleanWordsForAlarmSettingMode(settings.getLanguage(), matrix); // ES IST weg
          if (alarm.getShowAlarmTimeTimer() % 2 == 0) {
            matrix[4] |= 0b0000000000011111; // Alarm-LED
          }
          alarm.decShowAlarmTimeTimer();
        }
        break;
      case STD_MODE_SECONDS:
        renderer.clearScreenBuffer(matrix);
        for (byte i = 0; i < 7; i++) {
          matrix[1 + i] |= pgm_read_byte_near(&(ziffern[rtc.getSeconds() / 10][i])) << 11;
          matrix[1 + i] |= pgm_read_byte_near(&(ziffern[rtc.getSeconds() % 10][i])) << 5;
        }
        break;
      case EXT_MODE_LDR_MODE:
        renderer.clearScreenBuffer(matrix);
        if (settings.getUseLdr()) {
          for (byte i = 0; i < 5; i++) {
            matrix[2 + i] |= pgm_read_byte_near(&(staben['A' - 'A'][i])) << 8;
          }
        } else {
          for (byte i = 0; i < 5; i++) {
            matrix[2 + i] |= pgm_read_byte_near(&(staben['M' - 'A'][i])) << 8;
          }
        }
        break;
      case STD_MODE_BLANK:
      case STD_MODE_NIGHT:
        renderer.clearScreenBuffer(matrix);
        break;
      case STD_MODE_BRIGHTNESS:
        renderer.clearScreenBuffer(matrix);
        brightnessToDisplay = map(settings.getBrightness(), 1, 100, 0, 9);
        for (byte xb = 0; xb < brightnessToDisplay; xb++) {
          for (byte yb = 0; yb <= xb; yb++) {
            matrix[9 - yb] |= 1 << (14 - xb);
          }
        }
        break;
      case EXT_MODE_CORNERS:
        renderer.clearScreenBuffer(matrix);
        if (settings.getRenderCornersCw()) {
          for (byte i = 0; i < 5; i++) {
            matrix[2 + i] |= pgm_read_byte_near(&(staben['C' - 'A'][i])) << 11;
            matrix[2 + i] |= pgm_read_byte_near(&(staben['W' - 'A'][i])) << 5;
          }
        } else {
          for (byte i = 0; i < 5; i++) {
            matrix[0 + i] |= pgm_read_byte_near(&(staben['C' - 'A'][i])) << 8;
            matrix[5 + i] |= pgm_read_byte_near(&(staben['C' - 'A'][i])) << 11;
            matrix[5 + i] |= pgm_read_byte_near(&(staben['W' - 'A'][i])) << 5;
          }
        }
        break;
      case EXT_MODE_ENABLE_ALARM:
        renderer.clearScreenBuffer(matrix);
        if (settings.getEnableAlarm()) {
          for (byte i = 0; i < 5; i++) {
            matrix[0 + i] |= pgm_read_byte_near(&(staben['A' - 'A'][i])) << 11;
            matrix[0 + i] |= pgm_read_byte_near(&(staben['L' - 'A'][i])) << 5;
            matrix[5 + i] |= pgm_read_byte_near(&(staben['E' - 'A'][i])) << 11;
            matrix[5 + i] |= pgm_read_byte_near(&(staben['N' - 'A'][i])) << 5;
          }
        } else {
          for (byte i = 0; i < 5; i++) {
            matrix[0 + i] |= pgm_read_byte_near(&(staben['A' - 'A'][i])) << 11;
            matrix[0 + i] |= pgm_read_byte_near(&(staben['L' - 'A'][i])) << 5;
            matrix[5 + i] |= pgm_read_byte_near(&(staben['D' - 'A'][i])) << 11;
            matrix[5 + i] |= pgm_read_byte_near(&(staben['A' - 'A'][i])) << 5;
          }
        }
        break;
      case EXT_MODE_DCF_IS_INVERTED:
        renderer.clearScreenBuffer(matrix);
        if (settings.getDcfSignalIsInverted()) {
          for (byte i = 0; i < 5; i++) {
            matrix[0 + i] |= pgm_read_byte_near(&(staben['R' - 'A'][i])) << 11;
            matrix[0 + i] |= pgm_read_byte_near(&(staben['S' - 'A'][i])) << 5;
            matrix[5 + i] |= pgm_read_byte_near(&(staben['I' - 'A'][i])) << 11;
            matrix[5 + i] |= pgm_read_byte_near(&(staben['N' - 'A'][i])) << 5;
          }
        } else {
          for (byte i = 0; i < 5; i++) {
            matrix[0 + i] |= pgm_read_byte_near(&(staben['R' - 'A'][i])) << 11;
            matrix[0 + i] |= pgm_read_byte_near(&(staben['S' - 'A'][i])) << 5;
            matrix[5 + i] |= pgm_read_byte_near(&(staben['N' - 'A'][i])) << 11;
            matrix[5 + i] |= pgm_read_byte_near(&(staben['O' - 'A'][i])) << 5;
          }
        }
        break;
      case EXT_MODE_LANGUAGE:
        renderer.clearScreenBuffer(matrix);
        for (byte i = 0; i < 5; i++) {
          switch (settings.getLanguage()) {
            case LANGUAGE_DE_DE:
              matrix[2 + i] |= pgm_read_byte_near(&(staben['D' - 'A'][i])) << 11;
              matrix[2 + i] |= pgm_read_byte_near(&(staben['E' - 'A'][i])) << 5;
              break;
            case LANGUAGE_DE_SW:
              matrix[0 + i] |= pgm_read_byte_near(&(staben['D' - 'A'][i])) << 11;
              matrix[0 + i] |= pgm_read_byte_near(&(staben['E' - 'A'][i])) << 5;
              matrix[5 + i] |= pgm_read_byte_near(&(staben['S' - 'A'][i])) << 11;
              matrix[5 + i] |= pgm_read_byte_near(&(staben['W' - 'A'][i])) << 5;
              break;
            case LANGUAGE_DE_BA:
              matrix[0 + i] |= pgm_read_byte_near(&(staben['D' - 'A'][i])) << 11;
              matrix[0 + i] |= pgm_read_byte_near(&(staben['E' - 'A'][i])) << 5;
              matrix[5 + i] |= pgm_read_byte_near(&(staben['B' - 'A'][i])) << 11;
              matrix[5 + i] |= pgm_read_byte_near(&(staben['A' - 'A'][i])) << 5;
              break;
            case LANGUAGE_DE_SA:
              matrix[0 + i] |= pgm_read_byte_near(&(staben['D' - 'A'][i])) << 11;
              matrix[0 + i] |= pgm_read_byte_near(&(staben['E' - 'A'][i])) << 5;
              matrix[5 + i] |= pgm_read_byte_near(&(staben['S' - 'A'][i])) << 11;
              matrix[5 + i] |= pgm_read_byte_near(&(staben['A' - 'A'][i])) << 5;
              break;
            case LANGUAGE_CH:
              matrix[2 + i] |= pgm_read_byte_near(&(staben['C' - 'A'][i])) << 11;
              matrix[2 + i] |= pgm_read_byte_near(&(staben['H' - 'A'][i])) << 5;
              break;
            case LANGUAGE_EN:
              matrix[2 + i] |= pgm_read_byte_near(&(staben['E' - 'A'][i])) << 11;
              matrix[2 + i] |= pgm_read_byte_near(&(staben['N' - 'A'][i])) << 5;
              break;
            case LANGUAGE_FR:
              matrix[2 + i] |= pgm_read_byte_near(&(staben['F' - 'A'][i])) << 11;
              matrix[2 + i] |= pgm_read_byte_near(&(staben['R' - 'A'][i])) << 5;
              break;
            case LANGUAGE_IT:
              matrix[2 + i] |= pgm_read_byte_near(&(staben['I' - 'A'][i])) << 11;
              matrix[2 + i] |= pgm_read_byte_near(&(staben['T' - 'A'][i])) << 5;
              break;
            case LANGUAGE_NL:
              matrix[2 + i] |= pgm_read_byte_near(&(staben['N' - 'A'][i])) << 11;
              matrix[2 + i] |= pgm_read_byte_near(&(staben['L' - 'A'][i])) << 5;
              break;
            case LANGUAGE_ES:
              matrix[2 + i] |= pgm_read_byte_near(&(staben['E' - 'A'][i])) << 11;
              matrix[2 + i] |= pgm_read_byte_near(&(staben['S' - 'A'][i])) << 5;
              break;
          }
        }
        break;
      case EXT_MODE_TEST:
        renderer.clearScreenBuffer(matrix);
        renderer.setCorners(helperSeconds % 5, settings.getRenderCornersCw(), matrix);
        if (settings.getEnableAlarm()) {
          matrix[4] |= 0b0000000000011111; // Alarm-LED
        }
        for (int i = 0; i < 13; i++) {
          ledDriver.setPixelInScreenBuffer(x, i, matrix);
        }
        x++;
        if (x > 10) {
          x = 0;
        }
        break;
      case EXT_MODE_DCF_DEBUG:
        renderer.clearScreenBuffer(matrix);
        renderer.setCorners(dcf77.getBitPointer() % 5, settings.getRenderCornersCw(), matrix);
        break;
    }

    // Update mit onChange = true, weil sich hier (aufgrund needsUpdateFromRtc) immer was geaendert hat.
    // Entweder weil wir eine Sekunde weiter sind, oder weil eine Taste gedrueckt wurde.
    ledDriver.writeScreenBufferToMatrix(matrix, true);
  } //end if (needsUpdateFromRtc)

  /*
   *
   * Tasten abfragen (Code mit 3.3.0 ausgelagert, wegen der Fernbedienung)
   *
   */
  // M+ und H+ im STD_MODE_BLANK gedrueckt?
  if ((mode == STD_MODE_BLANK) && extModeDoubleButton.pressed()) {
    doubleExtModePressed();
  }

  // Taste Minuten++ (brighness++) gedrueckt?
  if (minutesPlusButton.pressed()) {
    minutePlusPressed();
  }

  // Taste Stunden++ (brightness--) gedrueckt?
  if (hoursPlusButton.pressed()) {
    hourPlusPressed();
  }

  // Taste Moduswechsel gedrueckt?
  if (modeChangeButton.pressed()) {
    modePressed();
  }

  /*
   *
   * Tasten der Fernbedienung abfragen...
   *
   */
#ifndef REMOTE_NO_REMOTE
  if (irrecv.decode(&irDecodeResults)) {
    DEBUG_PRINT(F("Decoded successfully as "));
    DEBUG_PRINTLN2(irDecodeResults.value, HEX);
    needsUpdateFromRtc = true;
    switch (irTranslator.buttonForCode(irDecodeResults.value)) {
      case REMOTE_BUTTON_MODE:
        modePressed();
        break;
      case REMOTE_BUTTON_MINUTE_PLUS:
        minutePlusPressed();
        break;
      case REMOTE_BUTTON_HOUR_PLUS:
        hourPlusPressed();
        break;
      case REMOTE_BUTTON_BRIGHTER:
        setDisplayBrighter();
        break;
      case REMOTE_BUTTON_DARKER:
        setDisplayDarker();
        break;
      case REMOTE_BUTTON_EXTMODE:
        doubleExtModePressed();
        break;
      case REMOTE_BUTTON_TOGGLEBLANK:
        setDisplayToToggle();
        break;
      case REMOTE_BUTTON_BLANK:
        setDisplayToBlank();
        break;
      case REMOTE_BUTTON_RESUME:
        setDisplayToResume();
        break;
      case REMOTE_BUTTON_SETCOLOR:
        ledDriver.setColor(irTranslator.getRed(), irTranslator.getGreen(), irTranslator.getBlue());
        break;
    }
    irrecv.resume();
  }
#endif

  /*
   *
   * Display zeitgesteuert abschalten?
   * Das Verbessert den DCF77-Empfang bzw. ermoeglicht ein dunkles Schlafzimmer.
   *
   */
  if ((offTime.getMinutesOfDay() != 0) && (onTime.getMinutesOfDay() != 0)) {
    if ((mode != STD_MODE_NIGHT) && (offTime.getMinutesOfDay() == rtc.getMinutesOfDay())) {
      mode = STD_MODE_NIGHT;
      ledDriver.shutDown();
    }
    if ((mode == STD_MODE_NIGHT) && (onTime.getMinutesOfDay() == rtc.getMinutesOfDay())) {
      mode = lastMode;
      ledDriver.wakeUp();
    }
  }

  /*
   *
   * Alarm?
   *
   */
  if ((mode == STD_MODE_ALARM) && (alarm.getShowAlarmTimeTimer() == 0) && !alarm.isActive()) {
    if (alarm.getAlarmTime()->getMinutesOf12HoursDay(0) == rtc.getMinutesOf12HoursDay()) {
      alarm.activate();
    }
  }
  if (alarm.isActive()) {
    // Nach 10 Minuten automatisch abschalten, falls der Wecker alleine rumsteht und die Nachbarn nervt...
    if (alarm.getAlarmTime()->getMinutesOf12HoursDay(MAX_BUZZ_TIME_IN_MINUTES) == rtc.getMinutesOf12HoursDay()) {
      alarm.deactivate();
      alarm.buzz(false);
      mode = STD_MODE_NORMAL;
    }
    // Krach machen...
    if (rtc.getSeconds() % 2 == 0) {
      alarm.buzz(true);
    } else {
      alarm.buzz(false);
    }
  }

  /*
   *
   * Die Matrix auf die LEDs multiplexen, hier 'Refresh-Zyklen'.
   *
   */
  if ((mode != STD_MODE_BLANK) && (mode != STD_MODE_NIGHT)) {
    ledDriver.writeScreenBufferToMatrix(matrix, false);
  }

  /*
   *
   * Status-LEDs ausgeben
   *
   */
#ifdef ENABLE_DCF_LED
  dcf77.statusLed(dcf77.signal(settings.getDcfSignalIsInverted()));
#endif
#ifdef ENABLE_SQW_LED
  rtc.statusLed(digitalRead(PIN_SQW_SIGNAL) == HIGH);
#endif

  /*
   *
   * DCF77-Empfaenger anticken...
   *
   */
  dcf77.poll(settings.getDcfSignalIsInverted());
}//loop()

/**
 * Was soll ausgefuehrt werden, wenn die H+ und M+ -Taste zusammen gedrueckt wird?
 */
void doubleExtModePressed() {
  needsUpdateFromRtc = true;
  DEBUG_PRINTLN(F("Minutes plus AND hours plus pressed in STD_MODE_BLANK..."));
  DEBUG_FLUSH();
  while (minutesPlusButton.pressed());
  while (hoursPlusButton.pressed());
  mode = EXT_MODE_START;
  ledDriver.wakeUp();
  DEBUG_PRINT(F("Entering EXT_MODEs, mode is now "));
  DEBUG_PRINT(mode);
  DEBUG_PRINTLN(F("..."));
  DEBUG_FLUSH();
}

/**
 * Was soll ausgefuehrt werden, wenn die Mode-Taste gedrueckt wird?
 */
void modePressed()
{
  needsUpdateFromRtc = true;
  if (alarm.isActive()) {
    alarm.deactivate();
    mode = STD_MODE_NORMAL;
  } else {
    mode++;
  }
  // Brightness ueberspringen, wenn LDR verwendet wird.
  if (settings.getUseLdr() && (mode == STD_MODE_BRIGHTNESS)) {
    mode++;
  }
  // Alarm ueberspringen, wenn kein Alarm enabled ist.
  if (!settings.getEnableAlarm() && (mode == STD_MODE_ALARM)) {
    mode++;
  }
  if (mode == STD_MODE_COUNT + 1) {
    mode = STD_MODE_NORMAL;
  }
  if (mode == EXT_MODE_COUNT + 1) {
    mode = STD_MODE_NORMAL;
  }

  if (mode == STD_MODE_ALARM) {
    // wenn auf Alarm gewechselt wurde, fuer 10 Sekunden die
    // Weckzeit anzeigen.
    alarm.setShowAlarmTimeTimer(10);
  }

  DEBUG_PRINT(F("Change mode pressed, mode is now "));
  DEBUG_PRINT(mode);
  DEBUG_PRINTLN(F("..."));
  DEBUG_FLUSH();

  // Displaytreiber ausschalten, wenn BLANK
  if (mode == STD_MODE_BLANK) {
    DEBUG_PRINTLN(F("LED-Driver: ShutDown"));
    DEBUG_FLUSH();
    ledDriver.shutDown();
  }
  // und einschalten, wenn BLANK verlassen wurde
  if (lastMode == STD_MODE_BLANK) {
    DEBUG_PRINTLN(F("LED-Driver: WakeUp"));
    DEBUG_FLUSH();
    ledDriver.wakeUp();
  }

  // Merker, damit wir nach einer automatischen Abschaltung
  // zum richtigen Mode zurueckkommen.
  lastMode = mode;

  // Werte speichern (die Funktion speichert nur bei geaenderten Werten)...
  settings.saveToEEPROM();
} //modePressed()

/**
 * Was soll ausgefuehrt werden, wenn die H+-Taste gedrueckt wird?
 */
void hourPlusPressed() {
  needsUpdateFromRtc = true;

  DEBUG_PRINTLN(F("Hours plus pressed..."));
  DEBUG_FLUSH();

  switch (mode) {
    case EXT_MODE_TIMESET:
      rtc.incHours();
      rtc.setSeconds(0);
      rtc.writeTime();
      rtc.readTime();
      helperSeconds = 0;
      DEBUG_PRINT(F("H is now "));
      DEBUG_PRINTLN(rtc.getHours());
      DEBUG_FLUSH();
      break;
    case EXT_MODE_TIME_SHIFT:
      if (settings.getTimeShift() > -13) {
        settings.setTimeShift(settings.getTimeShift() - 1);
      }
      break;
    case STD_MODE_ALARM:
      alarm.getAlarmTime()->incHours();
      alarm.setShowAlarmTimeTimer(10);
      DEBUG_PRINT(F("A is now "));
      DEBUG_PRINTLN(alarm.getAlarmTime()->asString());
      DEBUG_FLUSH();
      break;
    case STD_MODE_BRIGHTNESS:
      setDisplayDarker();
      break;
    case EXT_MODE_LDR_MODE:
      settings.setUseLdr(!settings.getUseLdr());
      if (!settings.getUseLdr()) {
        ledDriver.setBrightness(50);
      }
      DEBUG_PRINT(F("LDR is now "));
      DEBUG_PRINTLN(settings.getUseLdr());
      DEBUG_FLUSH();
      break;
    case EXT_MODE_CORNERS:
      settings.setRenderCornersCw(!settings.getRenderCornersCw());
      break;
    case EXT_MODE_ENABLE_ALARM:
      settings.setEnableAlarm(!settings.getEnableAlarm());
      break;
    case EXT_MODE_DCF_IS_INVERTED:
      settings.setDcfSignalIsInverted(!settings.getDcfSignalIsInverted());
      break;
    case EXT_MODE_LANGUAGE:
      if (settings.getLanguage() == 0) {
        settings.setLanguage(LANGUAGE_COUNT);
      } else {
        settings.setLanguage(settings.getLanguage() - 1);
      }
      break;
  }
}

/**
 * Was soll ausgefuehrt werden, wenn die M+-Taste gedrueckt wird?
 */
void minutePlusPressed() {
  needsUpdateFromRtc = true;

  DEBUG_PRINTLN(F("Minutes plus pressed..."));
  DEBUG_FLUSH();

  switch (mode) {
    case EXT_MODE_TIMESET:
      rtc.incMinutes();
      rtc.setSeconds(0);
      rtc.writeTime();
      rtc.readTime();
      helperSeconds = 0;
      DEBUG_PRINT(F("M is now "));
      DEBUG_PRINTLN(rtc.getMinutes());
      DEBUG_FLUSH();
      break;
    case EXT_MODE_TIME_SHIFT:
      if (settings.getTimeShift() < 13) {
        settings.setTimeShift(settings.getTimeShift() + 1);
      }
      break;
    case STD_MODE_ALARM:
      alarm.getAlarmTime()->incMinutes();
      alarm.setShowAlarmTimeTimer(10);
      DEBUG_PRINT(F("A is now "));
      DEBUG_PRINTLN(alarm.getAlarmTime()->asString());
      DEBUG_FLUSH();
      break;
    case STD_MODE_BRIGHTNESS:
      setDisplayBrighter();
      break;
    case EXT_MODE_LDR_MODE:
      settings.setUseLdr(!settings.getUseLdr());
      if (!settings.getUseLdr()) {
        ledDriver.setBrightness(50);
      }
      DEBUG_PRINT(F("LDR is now "));
      DEBUG_PRINTLN(settings.getUseLdr());
      DEBUG_FLUSH();
      break;
    case EXT_MODE_CORNERS:
      settings.setRenderCornersCw(!settings.getRenderCornersCw());
      break;
    case EXT_MODE_ENABLE_ALARM:
      settings.setEnableAlarm(!settings.getEnableAlarm());
      break;
    case EXT_MODE_DCF_IS_INVERTED:
      settings.setDcfSignalIsInverted(!settings.getDcfSignalIsInverted());
      break;
    case EXT_MODE_LANGUAGE:
      settings.setLanguage(settings.getLanguage() + 1);
      if (settings.getLanguage() > LANGUAGE_COUNT) {
        settings.setLanguage(0);
      }
      break;
  }
}

/**
 * Den DCF77-Empfaenger ein-/ausschalten.
 */
void enableDcf(boolean enable) {
  if (enable) {
    DEBUG_PRINTLN(F("DCF77-Empfaenger aufgeweckt."));
    DEBUG_FLUSH();
    digitalWrite(PIN_DCF77_PON, LOW);
  } else {
    DEBUG_PRINTLN(F("DCF77-Empfaenger schlafen gelegt."));
    DEBUG_FLUSH();
    digitalWrite(PIN_DCF77_PON, HIGH);
  }
}

/**
 * Korrekte Daten (auf Basis der Pruefbits) vom DCF-Empfaenger
 * bekommen. Sicherheitshalber gegen Zeitabstaende der RTC pruefen.
 */
void manageNewDCF77Data() {
  DEBUG_PRINT(F("Captured: "));
  DEBUG_PRINTLN(dcf77.asString());
  DEBUG_FLUSH();

  rtc.readTime();
  dcf77Helper.addSample(dcf77, rtc);
  // Stimmen die Abstaende im Array?
  // Pruefung ohne Datum, nur Zeit!
  if (dcf77Helper.samplesOk()) {
    rtc.setSeconds(0);
    rtc.setMinutes(dcf77.getMinutes());
    rtc.setHours(dcf77.getHours());
    // Wir setzen auch das Datum, dann kann man, wenn man moechte,
    // auf das Datum eingehen (spezielle Nachrichten an speziellen
    // Tagen). Allerdings ist das Datum bisher nicht ueber
    // den Abstand der TimeStamps geprueft, sondern nur ueber das
    // Checkbit des DCF77-Telegramms, was unzureichend ist!
    rtc.setDate(dcf77.getDate());
    rtc.setDayOfWeek(dcf77.getDayOfWeek());
    rtc.setMonth(dcf77.getMonth());
    rtc.setYear(dcf77.getYear());

    rtc.writeTime();
    DEBUG_PRINTLN(F("DCF77-Time written to RTC."));
    DEBUG_FLUSH();
    // falls im manuellen Dunkel-Modus, Display wieder einschalten... (Hilft bei der Erkennung, ob der DCF-Empfang geklappt hat).
    if (mode == STD_MODE_BLANK) {
      mode = STD_MODE_NORMAL;
      ledDriver.wakeUp();
    }
  } else {
    DEBUG_PRINTLN(F("DCF77-Time trashed because wrong distances between timestamps."));
    DEBUG_FLUSH();
  }
}

/**
 * Das Display toggeln (aus-/einschalten).
 */
void setDisplayToToggle() {
  if (mode != STD_MODE_BLANK) {
    setDisplayToBlank();
  } else {
    setDisplayToResume();
  }
}

/**
 * Das Display ausschalten.
 */
void setDisplayToBlank() {
  if (mode != STD_MODE_BLANK) {
    lastMode = mode;
    mode = STD_MODE_BLANK;
    DEBUG_PRINTLN(F("LED-Driver: ShutDown"));
    DEBUG_FLUSH();
    ledDriver.shutDown();
  }
}

/**
 * Das Display einschalten.
 */
void setDisplayToResume() {
  if (mode == STD_MODE_BLANK) {
    mode = lastMode;
    DEBUG_PRINTLN(F("LED-Driver: WakeUp"));
    DEBUG_FLUSH();
    ledDriver.wakeUp();
  }
}

/**
 * Das Display manuell heller machen.
 */
void setDisplayBrighter() {
  if ((!settings.getUseLdr()) && (settings.getBrightness() < 100)) {
    byte b = settings.getBrightness() + 10;
    if (b > 100) {
      b = 100;
    }
    settings.setBrightness(b);
    settings.saveToEEPROM();
    ledDriver.setBrightness(b);
  }
}

/**
 * Das Display dunkler machen.
 */
void setDisplayDarker() {
  if ((!settings.getUseLdr()) && (settings.getBrightness() > 1)) {
    int i = settings.getBrightness() - 0
            ;
    if (i < 2) {
      i = 1;
    }
    settings.setBrightness(i);
    settings.saveToEEPROM();
    ledDriver.setBrightness(i);
  }
}
