XaverBandi/Qlockthree_Eva_und_Xaver/Code/Anina_und_Ueli/Qlockthree/MyDCF77.cpp

/**
 * MyDCF77
 * Klasse fuer die Auswertung des DCF77-Zeitsignals.
 * Diese Klasse geht nicht von einem 'sauberen' Signal aus,
 * braucht aber eine externe 1-Sekunden-Basis. Sie ermittelt
 * die HIGH/LOWs statistisch.
 *
 * @mc       Arduino/RBBB
 * @autor    Christian Aschoff / caschoff _AT_ mac _DOT_ com
 * @version  1.1
 * @created  14.1.2015
 * @updated  16.2.2015
 *
 * Versionshistorie:
 * V 1.0:   - Erstellt.
 * V 1.1:   - Unterstuetzung fuer die alte Arduino-IDE (bis 1.0.6) entfernt.
 */
#include "MyDCF77.h"

// #define DEBUG
#include "Debug.h"

/**
 * Initialisierung mit dem Pin, an dem das Signal des Empfaengers anliegt
 */
MyDCF77::MyDCF77(byte signalPin, byte statusLedPin) {
    _signalPin = signalPin;
#ifndef MYDCF77_SIGNAL_IS_ANALOG
    pinMode(_signalPin, INPUT);
#endif

    _statusLedPin = statusLedPin;
    pinMode(_statusLedPin, OUTPUT);
    digitalWrite(_statusLedPin, LOW);

    clearBits();

    for (byte i = 0; i < MYDCF77_MEANCOUNT; i++) {
        _meanvalues[i] = MYDCF77_MEANSTARTVALUE;
    }
    _meanpointer = 0;
    _highcount = 0;
}

/**
 * Die LED ein- oder ausschalten.
 */
void MyDCF77::statusLed(boolean on) {
    if (on) {
        digitalWrite(_statusLedPin, HIGH);
    } else {
        digitalWrite(_statusLedPin, LOW);
    }
}

/**
 * Liegt ein Signal vom Empfaenger an?
 */
boolean MyDCF77::signal(boolean signalIsInverted) {
    boolean val;
#ifdef MYDCF77_SIGNAL_IS_ANALOG
    if (signalIsInverted) {
        val = analogRead(_signalPin) < MYDCF77_ANALOG_SIGNAL_TRESHOLD;
    } else {
        val = analogRead(_signalPin) > MYDCF77_ANALOG_SIGNAL_TRESHOLD;
    }
#else
    if (signalIsInverted) {
        val = (digitalRead(_signalPin) == LOW);
    } else {
        val = (digitalRead(_signalPin) == HIGH);
    }
#endif
    return val;
}

/**
 * Aufsammeln der Zustaende des DCF77-Signals.
 */
void MyDCF77::poll(boolean signalIsInverted) {
    if (signal(signalIsInverted)) {
        _highcount++;
    }
}

/**
 * Eine Sekunde startet. Muss von einem externen
 * Zeitgeber, z. B. einer RTC, aufgerufen werden.
 *
 * Zurueckgegeben wird ein Wahrheitswert.
 * TRUE bedeutet, das Zeittelegramm wurde korrekt ausgewertet, die Zeitdaten
 * koennen mit den Gettern abgerufen werden.
 * FALSE bedeutet, die Auswertung laeuft oder war falsch, die Getter liefern
 * alte Informationen.
 */
boolean MyDCF77::newSecond() {
    boolean retVal = false;

    if (_highcount != 0) {
        // Daten
        _meanvalues[_meanpointer] = _highcount;
        _meanpointer++;
        if (_meanpointer > MYDCF77_MEANCOUNT) {
            _meanpointer = 0;
        }

        unsigned long average = 0;
        for (byte i = 0; i < MYDCF77_MEANCOUNT; i++) {
            average += _meanvalues[i];
        }
        average /= MYDCF77_MEANCOUNT;

        DEBUG_PRINT(F("average = "));
        DEBUG_PRINT(average);
        DEBUG_PRINT(F("; highcount = "));
        DEBUG_PRINT(_highcount);

        if (_highcount > average) {
            _bits[_bitsPointer] = 1;
            DEBUG_PRINTLN(F("; HIGH"));
        } else {
            _bits[_bitsPointer] = 0;
            DEBUG_PRINTLN(F("; LOW"));
        }
        _bitsPointer++;
        if (_bitsPointer > MYDCF77_TELEGRAMMLAENGE) {
            _bitsPointer = 0;
        }
    } else {
        // Pause
        DEBUG_PRINTLN(F("PAUSE"));
        retVal = decode();
        _bitsPointer = 0;
        clearBits();
    }

    _highcount = 0;

    return retVal;
}

/**
 * Ein Bit im Array zum Debuggen (Anzeigen) bekommen.
 */
byte MyDCF77::getBitAtPos(byte pos) {
    return _bits[pos];
}

/**
 * Den Pointer zum Debuggen (Anzeigen) bekommen.
 */
byte MyDCF77::getBitPointer() {
    return _bitsPointer;
}

/**
 * Decodierung des Telegramms...
 */
boolean MyDCF77::decode() {
    int c = 0; // bitcount for checkbit
    boolean ok = true;

    DEBUG_PRINTLN(F("Decoding telegram..."));
    DEBUG_FLUSH();

    if (_bits[20] != 1) {
        ok = false;
        DEBUG_PRINTLN(F("Check-bit S failed."));
        DEBUG_FLUSH();
    }

    if (_bits[17] == _bits[18]) {
        ok = false;
        DEBUG_PRINTLN(F("Check Z1 != Z2 failed."));
        DEBUG_FLUSH();
    }

    //
    // minutes
    //
    _minutes = 0;
    c = 0;
    if (_bits[21] == 1) {
        c++;
        _minutes += _bits[21] * 1;
    }
    if (_bits[22] == 1) {
        c++;
        _minutes += _bits[22] * 2;
    }
    if (_bits[23] == 1) {
        c++;
        _minutes += _bits[23] * 4;
    }
    if (_bits[24] == 1) {
        c++;
        _minutes += _bits[24] * 8;
    }
    if (_bits[25] == 1) {
        c++;
        _minutes += _bits[25] * 10;
    }
    if (_bits[26]) {
        c++;
        _minutes += _bits[26] * 20;
    }
    if (_bits[27]) {
        c++;
        _minutes += _bits[27] * 40;
    }
    DEBUG_PRINT(F("Minutes: "));
    DEBUG_PRINTLN(_minutes);
    DEBUG_FLUSH();
    if ((c + _bits[28]) % 2 != 0) {
        ok = false;
        DEBUG_PRINTLN(F("Check-bit P1: minutes failed."));
        DEBUG_FLUSH();
    }

    //
    // hour
    //
    _hours = 0;
    c = 0;
    if (_bits[29] == 1) {
        c++;
        _hours += _bits[29] * 1;
    }
    if (_bits[30] == 1) {
        c++;
        _hours += _bits[30] * 2;
    }
    if (_bits[31] == 1) {
        c++;
        _hours += _bits[31] * 4;
    }
    if (_bits[32] == 1) {
        c++;
        _hours += _bits[32] * 8;
    }
    if (_bits[33] == 1) {
        c++;
        _hours += _bits[33] * 10;
    }
    if (_bits[34] == 1) {
        c++;
        _hours += _bits[34] * 20;
    }
    DEBUG_PRINT(F("Hours: "));
    DEBUG_PRINTLN(_hours);
    DEBUG_FLUSH();
    if ((c + _bits[35]) % 2 != 0) {
        ok = false;
        DEBUG_PRINTLN(F("Check-bit P2: hours failed."));
        DEBUG_FLUSH();
    }

    //
    // date
    //
    _date = 0;
    c = 0;
    if (_bits[36] == 1) {
        c++;
        _date += _bits[36] * 1;
    }
    if (_bits[37] == 1) {
        c++;
        _date += _bits[37] * 2;
    }
    if (_bits[38] == 1) {
        c++;
        _date += _bits[38] * 4;
    }
    if (_bits[39] == 1) {
        c++;
        _date += _bits[39] * 8;
    }
    if (_bits[40] == 1) {
        c++;
        _date += _bits[40] * 10;
    }
    if (_bits[41] == 1) {
        c++;
        _date += _bits[41] * 20;
    }
    DEBUG_PRINT(F("Date: "));
    DEBUG_PRINTLN(_date);
    DEBUG_FLUSH();

    //
    // day of week
    //
    _dayOfWeek = 0;
    if (_bits[42] == 1) {
        c++;
        _dayOfWeek += _bits[42] * 1;
    }
    if (_bits[43] == 1) {
        c++;
        _dayOfWeek += _bits[43] * 2;
    }
    if (_bits[44] == 1) {
        c++;
        _dayOfWeek += _bits[44] * 4;
    }
    DEBUG_PRINT(F("Day of week: "));
    DEBUG_PRINTLN(_dayOfWeek);
    DEBUG_FLUSH();

    //
    // month
    //
    _month = 0;
    if (_bits[45] == 1) {
        c++;
        _month += _bits[45] * 1;
    }
    if (_bits[46] == 1) {
        c++;
        _month += _bits[46] * 2;
    }
    if (_bits[47] == 1) {
        c++;
        _month += _bits[47] * 4;
    }
    if (_bits[48] == 1) {
        c++;
        _month += _bits[48] * 8;
    }
    if (_bits[49] == 1) {
        c++;
        _month += _bits[49] * 10;
    }
    DEBUG_PRINT(F("Month: "));
    DEBUG_PRINTLN(_month);
    DEBUG_FLUSH();

    //
    // year
    //
    _year = 0;
    if (_bits[50] == 1) {
        c++;
        _year += _bits[50] * 1;
    }
    if (_bits[51] == 1) {
        c++;
        _year += _bits[51] * 2;
    }
    if (_bits[52] == 1) {
        c++;
        _year += _bits[52] * 4;
    }
    if (_bits[53] == 1) {
        c++;
        _year += _bits[53] * 8;
    }
    if (_bits[54] == 1) {
        c++;
        _year += _bits[54] * 10;
    }
    if (_bits[55] == 1) {
        c++;
        _year += _bits[55] * 20;
    }
    if (_bits[56] == 1) {
        c++;
        _year += _bits[56] * 40;
    }
    if (_bits[57] == 1) {
        c++;
        _year += _bits[57] * 80;
    }
    DEBUG_PRINT(F("Year: "));
    DEBUG_PRINTLN(_year);
    DEBUG_FLUSH();
    if ((c + _bits[58]) % 2 != 0) {
        ok = false;
        DEBUG_PRINTLN(F("Check-bit P3: date failed."));
        DEBUG_FLUSH();
    }

    if (!ok) {
        // discard date...
        _minutes = 0;
        _hours = 0;
        _date = 0;
        _dayOfWeek = 0;
        _month = 0;
        _year = 0;
    }

    return ok;
}

/**
 * Das Zeittelegramm als String bekommen
 */
char* MyDCF77::asString() {
    _cDateTime[0] = 0;
    char temp[5];

    // build the string...
    if (_hours < 10) {
        sprintf(temp, "0%d:", _hours);
        strncat(_cDateTime, temp, strlen(temp));
    } else {
        sprintf(temp, "%d:", _hours);
        strncat(_cDateTime, temp, strlen(temp));
    }

    if (_minutes < 10) {
        sprintf(temp, "0%d ", _minutes);
        strncat(_cDateTime, temp, strlen(temp));
    } else {
        sprintf(temp, "%d ", _minutes);
        strncat(_cDateTime, temp, strlen(temp));
    }

    if (_date < 10) {
        sprintf(temp, "0%d.", _date);
        strncat(_cDateTime, temp, strlen(temp));
    } else {
        sprintf(temp, "%d.", _date);
        strncat(_cDateTime, temp, strlen(temp));
    }

    if (_month < 10) {
        sprintf(temp, "0%d.", _month);
        strncat(_cDateTime, temp, strlen(temp));
    } else {
        sprintf(temp, "%d.", _month);
        strncat(_cDateTime, temp, strlen(temp));
    }

    sprintf(temp, "%d", _year);
    strncat(_cDateTime, temp, strlen(temp));

    return _cDateTime;
}

/**
 * Das Bits-Array loeschen.
 */
void MyDCF77::clearBits() {
    for (byte i = 0; i < MYDCF77_TELEGRAMMLAENGE; i++) {
        _bits[i] = 0;
    }
    _bitsPointer = 0;
}

//
// Getter
//

byte MyDCF77::getMinutes() {
    return _minutes;
}

byte MyDCF77::getHours() {
    return _hours;
}

byte MyDCF77::getDate() {
    return _date;
}

byte MyDCF77::getDayOfWeek() {
    return _dayOfWeek;
}

byte MyDCF77::getMonth() {
    return _month;
}

byte MyDCF77::getYear() {
    return _year;
}
