XaverBandi/Qlockthree_Eva_und_Xaver/Code/Anina_und_Ueli/Qlockthree/DCF77Helper.cpp

/**
 * DCF77Helper
 * Klasse um die Qualitaet der DCF77-Samples zu verbessern. Dazu wird der Minutenabstand
 * zwischen den empfangenen DCF77-Samples mit Hilfe der Echtzeituhr verglichen.
 *
 * @mc       Arduino/RBBB
 * @autor    Christian Aschoff / caschoff _AT_ mac _DOT_ com
 * @version  1.8
 * @created  19.3.2011
 * @updated  16.2.2015
 *
 * Versionshistorie:
 * V 1.1:  - Fehler in der Initialisierung behoben.
 * V 1.2:  - Umstellung auf TimeStamps und Verbesserung des Plausibilitaetstests.
 * V 1.3:  - Fehler im samplesOk() behoben.
 * V 1.4:  - Kompatibilitaet zu Arduino-IDE 1.0 hergestellt.
 * V 1.5:  - Strings in PROGMEM ausgelagert.
 * V 1.6:  - Optimierung hinsichtlich Speicherbedarf.
 * V 1.7:  - Verbessertes Debugging.
 * V 1.8:  - Unterstuetzung fuer die alte Arduino-IDE (bis 1.0.6) entfernt.
 */
#include "DCF77Helper.h"

// #define DEBUG
#include "Debug.h"

/**
 * Initialisierung und das Array 'falsch' vorbelegen, damit der Zeitabstand
 * der Samples zum Anfang nicht stimmt.
 */
DCF77Helper::DCF77Helper() {
    _cursor = 0;
    for (byte i = 0; i < DCF77HELPER_MAX_SAMPLES; i++) {
        _zeitstempelDcf77[i] = new TimeStamp(i, i, i, i, i, i);
        _zeitstempelRtc[i] = new TimeStamp(100, 0, 0, 0, 0, 0);
    }
}

/**
 * Einen neuen Sample hinzufuegen.
 */
void DCF77Helper::addSample(MyDCF77 dcf77, MyRTC rtc) {
    DEBUG_PRINT(F("Adding sample from dcf77: "));
    _zeitstempelDcf77[_cursor]->setFrom(dcf77);
    DEBUG_PRINTLN(_zeitstempelDcf77[_cursor]->asString());

    DEBUG_PRINT(F("Adding sample from rtc: "));
    _zeitstempelRtc[_cursor]->setFrom(rtc);
    DEBUG_PRINTLN(_zeitstempelRtc[_cursor]->asString());
    DEBUG_FLUSH();

    _cursor++;
    if (_cursor == DCF77HELPER_MAX_SAMPLES) {
        _cursor = 0;
    }
}

/**
 * Die Samples vergleichen
 */
boolean DCF77Helper::samplesOk() {
    boolean ret = true;
    for (byte i = 0; i < DCF77HELPER_MAX_SAMPLES - 1; i++) {
        // Teste den Minutenabstand zwischen den Zeitstempeln...
        if ((_zeitstempelDcf77[i]->getMinutesOfDay() - _zeitstempelDcf77[i + 1]->getMinutesOfDay()) != (_zeitstempelRtc[i]->getMinutesOfDay() - _zeitstempelRtc[i + 1]->getMinutesOfDay())) {
            DEBUG_PRINT(F("Diff #"));
            DEBUG_PRINT(i);
            DEBUG_PRINT(F(" distance is wrong ("));
            DEBUG_PRINT(_zeitstempelDcf77[i]->getMinutesOfDay() - _zeitstempelDcf77[i + 1]->getMinutesOfDay());
            DEBUG_PRINT(F("!="));
            DEBUG_PRINT(_zeitstempelRtc[i]->getMinutesOfDay() - _zeitstempelRtc[i + 1]->getMinutesOfDay());
            DEBUG_PRINTLN(F(")."));
            DEBUG_FLUSH();
            ret = false;
        } else {
            DEBUG_PRINT(F("Diff #"));
            DEBUG_PRINT(i);
            DEBUG_PRINT(F(" distance is ok ("));
            DEBUG_PRINT(_zeitstempelDcf77[i]->getMinutesOfDay() - _zeitstempelDcf77[i + 1]->getMinutesOfDay());
            DEBUG_PRINT(F("=="));
            DEBUG_PRINT(_zeitstempelRtc[i]->getMinutesOfDay() - _zeitstempelRtc[i + 1]->getMinutesOfDay());
            DEBUG_PRINTLN(F(")."));
            DEBUG_FLUSH();
        }
    }

    return ret;
}
