XaverBandi/Qlockthree_Eva_und_Xaver/(commit log)

2016-06-18 Everything, not cleaned
    [Configuration.h, Schablone-Wortuhr.dxf]
2016-06-18 Extracted Anina_und_Ueli
    [Configuration.h]
